soldesign/SwarmPLCmodem/console/ping test.JPG

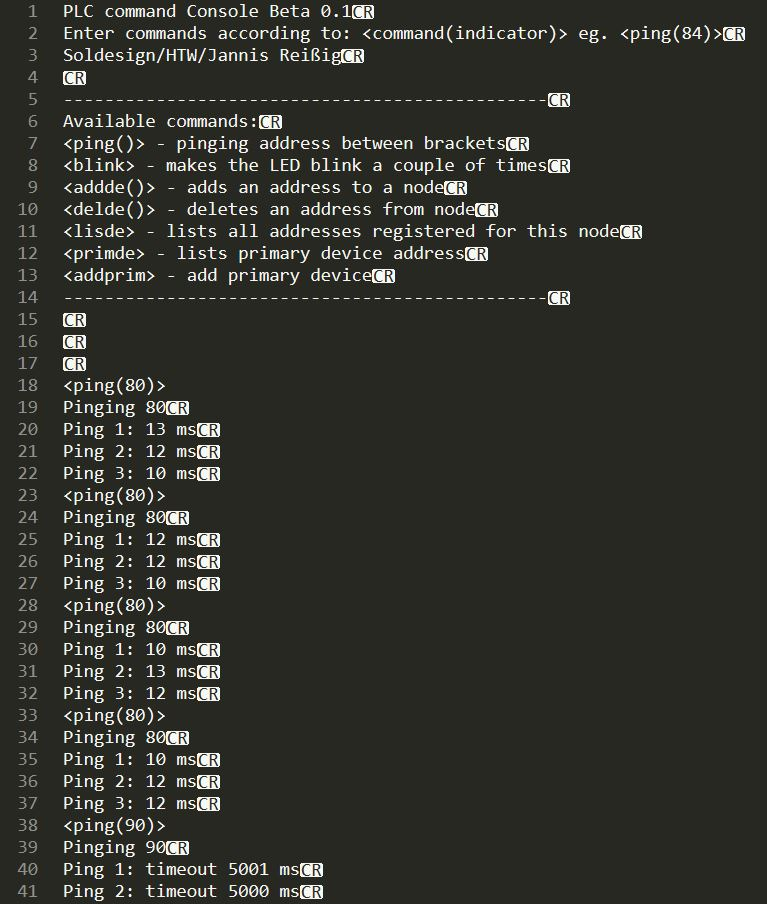
console/ping test.JPG
