soldesign/SwarmPLCmodem/3NodeTest/20180124_142106.jpg

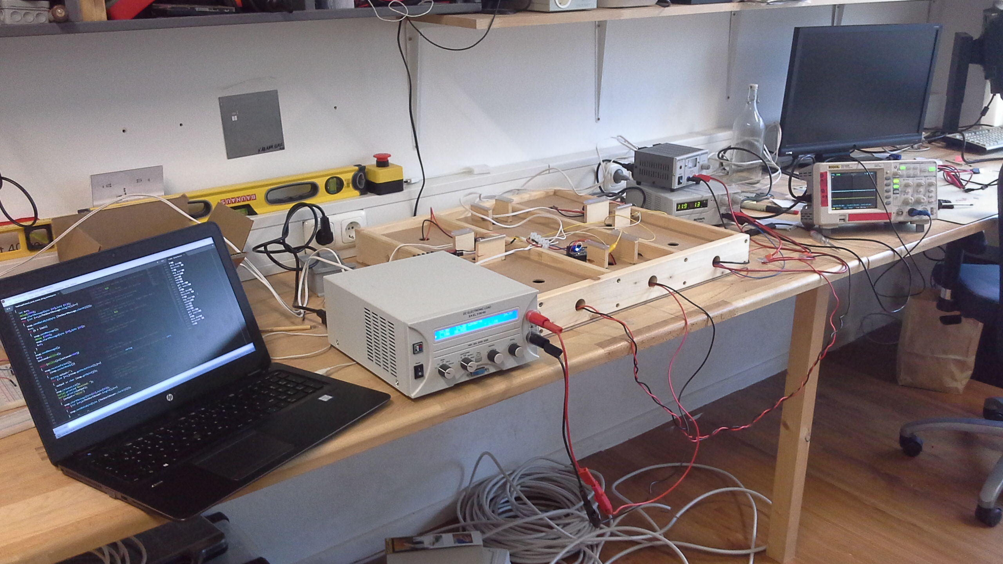
3NodeTest/20180124_142106.jpg
