soldesign/SwarmPLCmodem/US20030045970.pdf

# (19) United States

US 20030045970A1

## (12) Patent Application Publication (10) Pub. N0.: US 2003/0045970 A1

Maryanka | (43) Pub. Date: | Mar. 6, 2003
(54) SIGNALING OVER NOISY CHANNELS
(75) Inventor: Yair Maryanka, Tel Aviv (IL) Correspondence Address:
DR. MARK FRIEDMAN LTD
c/O ANTHONY CASTORINA
SUITE 207
2001 JEFFERSON DAVIS HIGHWAY ARLINGTON, VA 22202 (US)
(73) Assignee: YAMAR ELECTRONICS LTD
(21) Appl. No.: | 09/941,598
(22) Filed: | Aug. 30, 2001

Publication Classi?cation

(51) Int. Cl.7 | G05D 3/12; G05D 5/00;
G05D 9/00; G05D 11/00;
G05D 17/00
(52) US. Cl | 700/293

592

(57) ABSTRACT

The present invention relates to a system and method for signaling among a plurality of devices via a communication carrier over a noisy medium such as a poWer line and particularly relates to an innovative method and system for high speed signaling using an innovative modulating scheme. The scheme is particularly Well adapted for signal ing over multiple channels and over direct current (DC) poWer lines. At the transmitter end, a modem modulates data to be transmitted according to a modulation scheme and a signaling shifter modi?es the carrier according to a modi ?cation scheme. At the receiver end, a modem demodulates the data according to the modulation scheme and a detector detects the signal in accordance With the modi?cation scheme. Signals may be received over multiple channels. A signal is sent over a subset of the channels. Remaining channels can be used for competing signals avoiding inter ference. The channel chosen for sending a signal may also indicate signal priority. An innovative device is presenting for testing communication over DC poWer lines With adjust able attributes.

# 594b lose /

arbitration

536
send intend to | ‘534 x Postpone | Receive
use signaling | | transmission | Message

l
538 | listen for | 598
intend to use

## signaling

| 542
intend to | higher | lose | 4/. 5943
use? | priority | arbitration

### Start

Transmission 1

4

none or

## lower priority

win
arbitration

596

Patent Application Publication | Mar. 6, 2003 Sheet 1 0f 9 | US 2003/0045970 A1
0mm mwm | om.

# F mSmE

## N Erma .355

nww wwm | 3+ om. 3+ 8

## Bum ovm

# nmw

## iilili uozmn F _3E$

| om. 8+ 00. 8+8...

k
3%

## nvm oa

# own

# now

# mwu mmw mom

Patent Application Publication | Mar. 6, 2003 Sheet 4 0f 9 | US 2003/0045970 A1

# lll/ . nmhw

# v 23mm

0E. 35:» 03%. 9595mm 3b% 82a £2m E 5%.; 82a “25.9w at. 35% 29.5 @5335 vllllllllllllllllllll llllllllll n E65% 32a @5355

m

. W

# hm W g“image: 625E

n n" l uum E J WENgg £3: “ . .

kw mm .KQN “H KR E322 ._m.__.u._2=n_ Am mm QhwN at.“ Emuoi 3.35am vm H 2.3 E252 SREE mm 05w £5208: £555 m EM 5mm £5582 =2~§__.._ fnmhm nE-N .t" ...... u KHMHHNIiM. m om ERNEouQE EmRBBE

I. .555 @5655 223 n

# Ea $5.20 $80 mwm 68.21

L___..._.......__________ ___,____________......,.... ,__:=/

# ..\.., mmw

Patent Application Publication | Mar. 6, 2003 Sheet 6 0f 9 | US 2003/0045970 A1

# 11%? ²³⁹m @

00201 v

d a

n 361

a “02mm

# _‘ venom omw mugE

Patent Application Publication | Mar. 6, 2003 Sheet 7 0f 9 | US 2003/0045970 A1

# 3:23 .632 one: 3

### “"3: 5:25 cong?E

ill-ll»

## - :mE3 m. mmo

## 3% R . H Eg .5_

# wvm

# méwcmi ²⁹⁵ ⁸mm:* T/wnm gm in:..e

_\ ‘

## mémcm? comm??? m: mmmwmwz

# ml/ gm 295 ucmm 8@5931 mzmumm F

# mam

m .

53:26 52

32

959m N

Patent Application Publication | Mar. 6, 2003 Sheet 8 0f 9 | US 2003/0045970 A1

m m $8 $8 63222 “353

000

‘W.

m

# Jill 3% llmti mQw/vwl 3%

000 #8 3% :w ..

# wow w

83% 2 mé?gEEuu row

315v ugmuEzEEou .

w 9.5K

Patent Application Publication | Mar. 6, 2003 Sheet 9 0f 9 | US 2003/0045970 A1

# ommwwmE 0552mm c2382 ncmw mk $22, on 23% mL wagon ?omccou 23E

## 93mm m

## US 2003/0045970 A1

SIGNALING OVER NOISY CHANNELS

FIELD AND BACKGROUND OF THE INVENTION

[0001] The present invention relates to a system and method for signaling betWeen a plurality of devices over a noisy poWer line and particularly relates to innovative method and a system for high speed signals using a distinct modulating scheme over direct current (DC) poWer lines and multiple frequency channels, and an innovative device to test communication over DC poWer lines With adjustable conditions.
[0002] More and more tasks today require complete or partial computer control. Particularly in transportation, mul
tiple computers, sensors and actuators are an integral part of many machines. Cars, boats, aircraft, and trains use com puters to make the engine run ef?ciently, and to run climate control systems, radios, communication equipment, alarm systems, navigation equipment and on board radar. Tradi tionally, data Were passed betWeen computers, sensors and actuators through dedicated Wires and data buses. Large numbers of dedicated communication Wires greatly compli cates the production and maintenance of vehicles.
[0003] Recently there has developed interest in reducing the need for dedicated communication Wires by using exist ing electric poWer lines as a communication media. Interest has mostly been directed toWard using AC poWer lines to promote communication betWeen appliances, computers and equipment Within and between buildings.
[0004] Less attention has been directed toWard DC poWer lines, Which are used in vehicles. Using DC poWer lines for communication reduces the space and Weight dedicated to communication Wiring in vehicles including, for example, automobiles, trains, aircraft and satellites. Reducing the siZe and Weight of vehicles reduces cost of production and increases efficiency and performance.

### [0005] Maryanka (US. Pat. No. 5,727,025) teaches high

speed transmission of data over DC poWer lines With error control by means of channel coding and modulation. DC poWer-line communication may be over a single channel or multiple channels as presented in EAEC sixth European ITS conference in Cernobbio Italy on Jul. 2-4, 1997 by Mr. Aldo Romaro et al. “Super Integration In Automotive Electronics” page 1105.

[0006] When a plurality of devices communicates over a shared medium such as a DC poWer line, there is a need to coordinate sharing of the media. Therefore, in order to facilitate communication over noisy media such as DC poWer lines there must an ef?cient signaling method. Sig naling is used for sending predetermined messages; for example, to turn on or off a particular appliance. Signaling is also used for sending of supervisory information for maintaining communication on a channel. For example: a transmitter uses signaling to instruct a receiver to prepare for a neW transmission; a transmitter uses signaling to indicate intention to use a channel in order to prevent other trans mitters from interfering With communication on the channel; a receiver uses signaling to inform a transmitter of a recep tion error; a receiver uses signaling to inform a transmitter of a speed limitation, a receiver uses signaling to inform a transmitter of a congestion condition Wherein the receiver

## Mar. 6, 2003

cannot receive (for example: due to a full input buffer or due to an incoming message on a separate channel), a receiver uses signaling to send to a transmitter a request to retransmit.
[0007] Signaling is commonly used for collision detection and collision resolution (detection of potential interference betWeen transmissions by multiple devices on a channel and coordination of communication to avoid the interference). For ef?cient collision detection and resolution on a noisy channel, it is necessary to have a signaling method by Which competing transmitting devices can quickly signal their
intention to use the channel preventing other transmitters from accessing the channel.
[0008] DC poWer lines are considered typically as very noisy communication channels With high level impulse
noises, causing communication errors over a Wide range of frequencies. In addition, part of the frequencies available for communication may be blocked for long period of time as a result of Electro Magnetic Interference (EMI) or strong attenuation resulting from inter-symbol interference, fading
and standing Waves. The combination of Wide band short term impulse noise and long time period narroW band interference places stringent demands on signaling. Speci? cally, the high probability of blocked channels and the large
number of communication errors over DC poWer-lines results in an increased burden of coordination and an increased number of signals. On a noisy channel, signals must be resistant to frequency notch and blocking by noise.
[0009] Communication can be for the purpose of transfer ring arbitrary data or for the purpose of sending one of a predetermined set of messages. Errors cannot be readily detected or corrected in arbitrary data. Therefore, arbitrary data is generally transmitted via symbol codes that have high
resistance to random errors. Resistance to errors in symbol
codes is achieved by lengthening the symbol transmission period. Lengthening the symbol transmission period sloWs
communication.
[0010] Signaling is used for sending a message taken from a predetermined limited set of potential messages. A prede termined ?nite domain of signals corresponds to the prede termined ?nite set of messages. When a signal is corrupted, the corrupted signal Will seldom correspond to a signal in the domain of potential signals. Therefore, an error is easily recogniZed. When there is an error, the original intended signal can be retrieved by ?nding the legitimate signal most similar to the received signal. Thus, signals are inherently resistant to changing the meaning (aliasing). Therefore, the use in signaling of lengthened symbol codes developed for arbitrary data communication implies redundant error pro tection. Redundant error protection is inef?cient and unnec
essarily sloWs signaling.
[0011] VanderMey et al. (US. Pat. No. 6,034,988) teach a spread spectrum apparatus and method for netWork RF data

communications having extended communication channels. The spectrum spreading method of VanderMey ’988 is frequency hopping across a plurality of channels. Frequency hopping alloWs communication over noisy media. In order to permit simultaneous data hopping and carrier sensing multiple access—collision detection (CSMA-CD) Vander
Mey ’988 requires a means of fast signaling of a free channel. According to VanderMey ’988 fast signaling is to be achieved by a RF signal Within one sub-symbol of a data packet. HoWever, noWhere does VanderMey ’988 disclose a one sub-symbol signaling method. VanderMey does reveal a signaling method by a code of multiple symbols. Because each frequency hop must Wait until a signal can be detected on a neW channel, signal detection by a code of multiple symbols signi?cantly sloWs communication in the Vander Mey ’988 method.
[0012] Jaffe et al. (US. Pat. No. 5,485,147) teach a method and apparatus for scheduling access to a CSMA

communication medium. According to the method of J affe et al. ’147 signaling is over a dedicated channel that is not available for arbitrary data communication. The additional channel increases netWork cost because the additional chan nel requires eXtra hardWare for each component of the netWork and requires eXtra bandWidth.
[0013] Gold et al. (US. Pat. No. 5,488,631) teach a Wireless direct-sequence spread spectrum TDMA commu

nications system. The patent of Gold et al. ’631 discloses a
physical layer method for communication including signal
ing. The signaling method of Gold et al. ’631 is direct sequence spread spectrum communication (D555). D555 Was developed for arbitrary data communication. As such DSSS does not take advantage of the limited domain of signals. Thus signaling requests according to Gold et al. ’631 require more communication resources than optimiZed sig naling. Furthermore, DSSS requires the generation of com pleX pseudo-noise functions and modulation and demodu

lation of signals by means of the pseudo-noise functions. Generation and modulation With pseudo-noise functions increases the complication and eXpense of each transmitter and receiver on the netWork of Gold et al. ’631. The system of Gold et al. ’631 is Well suited for a D555 netWork Wherein transmitters and receivers are necessarily equipped With pseudo-random code generators and modulators and
Wherein messages are long. But in a netWork Where mes sages are short and devices are relatively simple, the method of Gold et al. ’631 requires dedication of an unnecessarily large quantity of resources to CSMA-CD and signaling.
[0014] Thompson (US. Pat. No. 5,726,976) teaches a
congestion sense controlled access for a star con?gured netWork. According to Thompson ’976 the communication
rate can be increased over a carrier sense netWork (With
emphasis on Ethernet netWorks) by reduction of the packet length. Thompson ’976 further reveals a method for dupleX communication over star con?gured netWork. In order to
achieve full duplex, Thompson ’976 requires in-band sig
naling. While one goal of Thompson ’976 is to reduce the communication packet length the revealed method of in band signaling requires block encoding including eXtra signaling bits in the transmitted data. Block encoding increases the packet length and decreases communication
ef?ciency.
[0015] Communication devices are often required to func tion under a variety of conditions. For eXample a particular set of devices may be used in different vehicles and under different operating conditions. When developing or trouble shooting a communication device it is unfeasible and pro hibitively expensive to install and test a device in every possible con?guration and under all possible conditions. Therefore testing is done using a testing apparatus.
[0016] Prior art systems for testing a communication device require installation into a particular environment or do not alloW for varying the testing conditions Without permanent modi?cation of the testing apparatus. For eXample, WiecZorek, et al. (US. Pat. No. 5,703,479) reveal a system for loopback testing of electronic equipment. But

the method of WiecZorek et al. ’479 makes no alloWance for changing conditions under Which the equipment operates. Fieramosca, et al. (US. Pat. No. 5,950,149) reveal a “Method for testing vehicle electrical system during manu

facturing”. The method of Fieramosca et al. ’149 requires testing the electrical system after installation in a car and cannot make account for individual differences betWeen cars or changes in conditions (for eXample, as a car ages). Yoshida, et al. (US. Pat. No. 6,205,202) reveal a method of testing home communications lines. Yoshida ’202 fails to consider the importance of differing performance under particular environmental conditions.
[0017] There is thus a Widely recogniZed need for, and it Would be highly advantageous to have a signaling system and method to alloW fast signaling and CSMA-CR over noisy communication circuits. Further, there is a Widely recogniZed need for, and it Would be highly desirable to have a device to facilitate testing of communication installed in different pieces of equipment or functioning under varying environmental conditions.
[0018] De?nitions
[0019] For the sake of the present patent the folloWing de?nitions Will be used:
[0020] a collision is an intent of a plurality of trans mitters to transmit during a particular common time period on a speci?c channel;
[0021] a collision resolution is a decision not to transmit during the particular time period on the speci?c channel in all but one transmitter involved in
a collision.
[0022] a channel is a de?ned part of communication carrier through Which a limited quantity of informa tion is transmitted; for eXample, a channel may include a frequency band from a frequency range in a radio signal or in an optical signal, and a Wire from a group of Wires;
[0023] a communication carrier is a vehicle by Which a message may be sent; electromagnetic Waves,
sound or ultra-sonic vibrations are common
eXamples of communication carriers;
[0024] a communication medium is a physical vessel for conveying a communication carrier; eXamples of
media include but are not limited to a Wire, an electromagnetic ?eld, a conduit, and an optical ?ber;
[0025] a device is a member of communication net Work that may include components to serve any function and is con?gured to send a signal, receive a signal or both transmit and receive a signal.

SUMMARY OF THE INVENTION

[0026] The present invention is a system and method for signaling among a plurality of devices over a noisy medium and particularly relates to innovative method and system for high-speed signals using a distinct modulating scheme over direct current (DC) poWer lines and multiple frequency channels. The invention further reveals an innovative device to test communication over DC poWer lines With adjustable conditions.
[0027] According to the teachings of the present invention there is provided a method of transmitting an arbitrary datum over a channel and for sending a signal over the channel. The method includes the steps of modulating the arbitrary datum onto a carrier by a modulation scheme for transmitting the arbitrary datum and modifying the carrier by a modi?cation scheme for sending the signal.
[0028] According to further features in preferred embodi
ments of the invention described beloW the modulation scheme includes transmitting a plurality of consecutive symbols at a symbol rate and the modi?cation scheme includes modifying said carrier at a modi?cation rate, the modi?cation rate being higher or loWer than the symbol rate.
[0029] According to further features in preferred embodi
ments of the invention described beloW the modulation or the modi?cation may be effected by binary phase shift keying (BPSK), quadrature phase shift keying (QPSK), amplitude modulation (AM), frequency modulation (FM), or code division multiple access (CDMA).
[0030] According to still further features in preferred embodiments of the invention described beloW the signal is used to communicate a message that includes but is not limited to an intention to transmit, an end of transmission, a congestion condition (for eXample a full receive buffer or a receiver speed limitation), an instruction to turn on a device, and instruction to turn off a device, a request to retransmit,
a dominant status and a recessive status.
[0031] According to still further features in preferred embodiments of the invention described beloW the carrier is conveyed over a medium. The medium may include but is not limited to a utility poWer line, a DC poWer line, a dedicated communication Wire, a ?ber optic cable, and a magnetic ?eld.
[0032] According to still further features in preferred embodiments of the invention described beloW the modu lating and the modifying are effected substantially simulta
neously.
[0033] According to still further features in preferred embodiments of the invention described beloW the pattern of modi?cations is used to estimate the channel probability of errors and to adjust the usage of a channel according to that estimated probability of communication errors.
[0034] According to another embodiment of the present invention there is provided, a receiver for receiving an arbitrary datum from a channel of a communication carrier and for receiving a signal over the channel. The receiver includes a modem for demodulating the arbitrary datum and a detector to detect the signal. The datum is modulated by a modulation scheme and the signal is sent via modi?cations of the carrier according to a modi?cation scheme.
[0035] According to further features in preferred embodi
ments of the invention described beloW the modi?cation scheme includes a pattern of modi?cations to the carrier. In order to identify the pattern, the receiver includes a proces

sor.
[0036] According to still further features in preferred embodiments of the invention described beloW the modu lation scheme includes modulating a symbol onto the carrier over a symbol period and the pattern includes a plurality of modi?cations Within the symbol period.
[0037] According to still further features in preferred embodiments of the invention described beloW the processor includes consisting of but is not limited to a programmable logic array device, an application speci?c integrated circuit, or a digital signal processor.
[0038] According to still further features in preferred embodiments of the invention described beloW the modu lation scheme includes modulating a plurality of symbols onto the carrier at a symbol rate and the pattern includes a plurality of modi?cations. The modi?cations are superim posed onto the carrier at a modi?cation rate. The modi?ca tion rate may be higher or loWer than said symbol rate.
[0039] According to still further features in preferred
embodiments of the invention described beloW a pattern identi?cation criterion is adjusted according to communica tion performance.
[0040] According to still further features in preferred embodiments of the invention described beloW the processor further adjusts a usage of a channel for an arbitrary datum transmission according to communication performance.
[0041] According to yet another embodiment of the present invention there is provided a transmitter. The trans mitter is for transmitting an arbitrary datum over a channel of a communication carrier and for sending a signal over the channel. The transmitter includes a modem for modulating the arbitrary datum according to a modulation scheme, and a signaling shifter to modify the communication carrier according to a modi?cation scheme.
[0042] According to still further features in preferred embodiments of the invention described beloW the modi? cation scheme includes a pattern of modi?cations. In order to produce the pattern, the transmitter further includes a signaling pattern generator for controlling the shifter.
[0043] According to still further features in preferred embodiments of the invention described beloW the modu lation scheme includes modulating a symbol onto the carrier over a symbol period and the signaling pattern includes a plurality of modi?cations. The pattern is transmitted Within the symbol period.
[0044] According to still further features in preferred embodiments of the invention described beloW the modu lation scheme includes modulating a plurality of symbols onto the carrier at a symbol rate and the modi?cation scheme includes a plurality of modi?cations at a modi?cation rate. The modi?cation rate may be higher or loWer than the symbol rate.
[0045] According to still further features in preferred embodiments of the invention described beloW the signaling pattern generator includes a processor. The processor may include but is not limited to a programmable logic array device, an application speci?c integrated circuit, and a digital signal processor.
[0046] According to still further features in preferred embodiments of the invention described beloW the signaling pattern is altered to adjust the usage of a channel according to communication performance.

[0047] According to yet another embodiment of the present invention there is provided a method of signaling during communication by a plurality of devices over a plurality of channels. The method includes the steps of a ?rst devices sending a ?rst signal on a ?rst channel and a second device listening for the signal over a subset of the channels. The subset of channels includes the ?rst channel and a second channel.
[0048] According to still further features in preferred embodiments of the invention described beloW the signaling method further includes the step of the ?rst device detecting a second signal over the second channel.
[0049] According to still further features in preferred embodiments of the invention described beloW the second device includes a transmitter. The second device listens for a signal for the sake of collision detection or collision resolution. The transmitter of the second device transmits according to arbitration of the signal resolution.
[0050] According to still further features in preferred embodiments of the invention described beloW the ?rst signal is communicating an intention to transmit over some or all of the channels.
[0051] According to still further features in preferred embodiments of the invention described beloW the method of signaling for collisions resolution further includes the step of assigning a signal priority level to the ?rst signal. Reso lution of con?icts is according to the signal priority level.
[0052] According to still further features in preferred
embodiments of the invention described beloW a channel of the subset of channels used for signaling is associated With a channel priority level. The signal priority level is assigned according to the channel priority of the channel over Which the signal is sent.
[0053] According to yet another embodiment of the present invention there is provided a method for signaling during communication by a plurality of transmitters over a plurality of channels. The method includes the steps of sending a ?rst signal from one of the transmitters on at least one channel and listening by the transmitter for a second signal from a second transmitter over a second channel.
[0054] According to yet another embodiment of the present invention there is provided a system for testing
communication amongst a plurality of devices over a medium. The system comprises an adjuster to change an attribute of the medium and a DC poWer supply for supply ing a DC voltage to the devices. The DC poWer supply is decoupled from transmissions from the devices by an induc
tor.
[0055] According to still further features in preferred embodiments of the invention described beloW the attribute of the medium changed by the adjuster includes but is not limited to attenuation, impedance, frequency response, noise pattern, or noise level.
[0056] According to yet another embodiment of the present invention there is provided a method for testing communication betWeen tWo devices via a medium. The method comprises the steps of connecting the devices to the medium, adjusting an attribute of the medium, conveying a
message over the medium from a ?rst device to a second device, determining Whether the message is received by the second device; and imposing a DC voltage on at least one of the devices.
[0057] The present invention successfully addresses the shortcomings of the presently knoWn con?gurations by providing a method and system for fast signaling. Signals may be sent at a rate higher than a symbol rate. Fast signaling makes communication betWeen multiple devices more efficient. Fast, reliable signaling is particularly increases ef?ciency of communication over a noisy medium such as a DC poWer line. The current invention also dis closes a novel system and method for testing communication over a DC poWer line. The system and method for testing communication saves money developing and testing com munication devices by enabling testing of communication under varied Working conditions Without requiring installa tion of communication devices in different vehicles.

BRIEF DESCRIPTION OF THE DRAWINGS
[0058] The invention is herein described, by Way of eXample only, With reference to the accompanying draWings, Wherein:
[0059] FIG. 1 is a schematic illustration of a modi?ed Wave used for signaling according to the present invention;
[0060] FIG. 2a is a schematic draWing of an embodiment of signaling phase detector according to the present inven tion;
[0061] FIG. 2b is a schematic draWing of an embodiment of a signaling phase shifter according to the present inven tion;
[0062] FIG. 3 is a schematic draWing of an embodiment of a multi-channel receiver With signaling according to the present invention;
[0063] FIG. 4 is a schematic draWing of an embodiment of a multi-channel transmitter With signaling according to the present invention;
[0064] FIG. 5 is a schematic draWing of an alternative embodiment of a multi-channel transmitter according to the current invention;
[0065] FIG. 6 is a schematic illustration of a collision resolution on a single channel according to the current
invention;
[0066] FIG. 7 is a How chart of a method for collision resolution according to the present invention;
[0067] FIG. 8 is a schematic draWing of a system to test signaling and communication amongst devices according to the present invention.
[0068] FIG. 9 is a How chart of a method for testing a communication amongst devices according to the present invention.

DESCRIPTION OF THE PREFERRED EMBODIMENTS

[0069] The present invention relates to a method for signaling among a plurality of devices over a noisy media and particularly relates to an innovative method and a system for signaling over DC poWer lines and an innovative device to test signaling and communication over DC power lines amongst a plurality of devices under varied conditions.
[0070] The principles and operation of method and a system for signaling over noisy media such as DC poWer lines according to the present invention may be better understood With reference to the draWings and the accom
panying description.
[0071] FIG. 1 illustrates a signaling Waveform according
to the current invention. For illustrative purposes the Wave form is shoWn repeated tWice. The medium in FIG. 1 is a DC poWer line. The carrier in FIG. 1 is a RF Wave. The signaling channel is a frequency band. The frequency band is primarily used for arbitrary data communication. The arbitrary data communication modulation scheme in FIG. 1 is BPSK at a symbol rate of 636 kHZ. In BPSK modulation, symbols are communicated by 90 degree phase shifts 20a and 20b at the beginning 22a, 22b of each symbol period. For example, the symbols are bits and the symbol period is 1/636,000 sec. In FIG. 1, are shoWn tWo consecutive symbols. In the embodiment of FIG. 1, the symbol period for arbitrary data communication, is six cycles of the carrier Wave. Phase shifts for arbitrary communication are alWays at the begin ning of a symbol period and never Within the symbol period. In order that the symbol period include six cycles of the carrier Wave at a symbol rate of 636 kHZ, the carrier frequency is 3.8 MHZ. Other common modulation schemes include but are not limited to QPSK, FM, AM, CDMA and combination of the above modulation schemes such as
frequency key shifting for arbitrary datum and amplitude modulation for signaling.
[0072] Random noise on the channel causes random phase shifts of the carrier Wave. A data error occurs When noise causes a consistent shift over most of the symbol period. Random noise is unlikely to consistently affect the phase of the Wave over many cycles. Therefore, as the symbol period increases, the likelihood of errors from random noise decreases.
[0073] In the embodiment of FIG. 1, fast signaling is achieved by modifying the carrier With a scheme of multiple phase shifts Within a single pattern period. There is at least one full cycle of the carrier Wave betWeen any tWo phase shifts to alloW differentiation betWeen Sine and Cosine Waves. In a real netWork, signals and arbitrary communica tion symbols are not generally transmitted simultaneously. Nevertheless, for the sake of illustration, FIG. 1 includes phase shifts 24a-24e for signaling. Phase shifts for signaling may also occur at the beginning of a symbol period, for example phase shifts 20a-20b. Speci?cally one symbol period in FIG. 1 contains six phase shifts for signaling 24a, 24b, 24c, 24d, 24c and 20b. Thus the modi?cation rate is 6><636=3.8 MHZ. Phase shifts 24a-24e and 20b, Within one symbol period are +90, +90, —90, +90, —90 and —90 degrees. Thus, in arbitrary data communication When using BPSK
modulation, only one binary bit can be transmitted in a single a symbol period. Whereas in signaling, one of up to 26 predetermined signals can be transmitted in a pattern period. In FIG. 1, the signaling pattern period and the arbitrary data symbol period are the same length. In an alternative embodiment, the signaling period could be longer or shorter than the arbitrary data symbol period. In FIG. 1, the pattern rate is equal to the carrier frequency. The pattern rate may be less than the carrier frequency. In actuality, the number of predetermined potential signals is
much less than 26 therefore only a feW patterns are legitimate signals. The small ratio of legitimate signaling patterns to possible patterns alloWs distinction betWeen noise and intended signaling patterns. Multiple-phase shifts in a short period increase the likelihood that a receiver Will not detect all of the phase shifts. Therefore in the embodiment of FIG. 1, When a receiver receives a pattern, Which may not be an exact replica of the transmitted signal, the receiver must decide if the pattern resembles a knoWn signal. For example, the criterion for identi?cation of the signal of FIG. 1 is detecting ?ve of the six phase shifts of the pattern of FIG. 1.
[0074] Other possible modi?cation schemes include but are not limited to amplitude shifting or frequency shifting. For example, multiple amplitude shifts may be made in a symbol period and amplitude shifts may be by a factor of 0, —1, or 1/2.
[0075] A modi?cation of a carrier for the sake of signaling according to the present invention is not limited to changing the phase of an electrical Wave. The carrier of a signal may be light for example in a ?ber optic cable. Similarly the communication medium may be an air conduit and the communication carrier may be sound Waves. Methods used to modulate the carrier may include frequency modulation and amplitude modulation. Further examples of modi?ca tions include frequency shifting for example a PM chirp or modi?cation of chirps.
[0076] FIG. 2a is an example of a signaling phase detector 70 for detecting phase modi?cations in a carrier of a signal
100. Signal 100 consists of phase shifts similar to the signaling Waveform in FIG. 1. A digital logic circuit con tains tWo detector arrays 105i and 105q. Detector arrays 105i and 105q contain generators of a reference signal I 125i and a reference signal Q 125q respectively. Reference signal Q is shifted by 90 degrees from reference signal I. Both reference signals Q and I have the same frequency corre sponding to a transmitter carrier Wave. Both reference signals Q and I are synchroniZed to received signal 100 by means of a Phase Lock Loop 115. Received carrier signal 100 passes through a band pass ?lter 275a'a'. The central frequency of ?lter 275a'd is the base frequency of the transmitter carrier Wave of signal 100. Signal 100 is con verted by a comparator 130 into digital form and compared With reference signals I and Q. Detector arrays, 105i and 105q further each contain a fast counter FCI 135i and FCQ 135q respectively. A phase difference betWeen received signal 100 and reference signals I and Q is measured by means of fast counters FCI 135i and FCQ 135q. Aprocessor 140 compares expected phase values to measured phase values of the carrier Wave of signal 100. If the difference is less than a preset threshold, the decision logic outputs a “signaling detected” response 145 as required according to signal 100. Based on differences betWeen expected phase shifts and detected phase shifts, processor 140 evaluates communication performance. For example, processor 140 provides an estimated channel bit error rate to output 146. Processor 140, detector arrays 1051 and 105q, and PLL 115 may include but are not limited to a programmable logic array device, an application speci?c integrated circuit and/or a digital signal processor. Different types of decision logic

processors 140 can be implemented for more sophisticated soft decisions. The band pass ?lter 275a'a' can be imple mented as discrete LC ?lter or as a digital ?lter.
[0077] Processor 140 evaluates communication perfor mance based on the difference betWeen a received signaling

pattern and an expected pattern. Estimation of communica tion performance may be made periodically using a knoWn calibration pattern, or estimation of communication perfor mance may be made “on line” based on received signals.
[0078] For example, for the pattern of FIG. 1, processor 140 tracks the number of signals Wherein all six phase shifts are detected and the number of signals Wherein only ?ve of the six phase shifts are detected. When the ratio of signals With six detected shifts to signals With ?ve detected shifts is less than 100:1, then it is assumed that some signals With four detectable shifts are being lost. Therefore, processor 140 adjusts the usage of the channel. Alternatively, along With identifying signi?cant signals Wherein ?ve or six of phase shifts from amongst 20a and 20b and 24a-24e are detected, processor 140 also tracks possibly missed mes sages Wherein four phase shifts from amongst 20a and 20b and 24a-24e are detected. When the ratio of signi?cant signals to possibly missed messages is less than 1000: 1, then it is assumed that some signals With four detectable shifts are being lost. Therefore, processor 140 adjusts the usage of a channel both for arbitrary datum and signaling.
[0079] Strategies to adjust the usage of a channel include but are not limited to change a pattern length, change a pattern identi?cation criterion and cease use of a channel for communication. By altering a signaling pattern length or a criterion for pattern identi?cation, the probability of signal ing errors (false negative or false positive) can be adjusted according to channel noise.
[0080] Methods by Which processor 140 adjusts a usage of a channel for an arbitrary datum transmission according to communication performance include but not limited to changing a symbol rate and changing an error protection ECC algorithm. In order to change an ECC algorithm, processor 140 sends a signal to a transmitter, instructing the transmitter to change ECC. The transmitter automatically informs intended receivers of the chosen ECC. For example, When the communication error rate is high, processor 140 sends a signal to a transmitter to change to a longer ECC that can correct a higher proportion of errors.
[0081] For example in the embodiment of FIG. 1, When a large number signals are being lost (false negative), proces sor 140 decides to change the pattern identi?cation criterion

by reducing the required number of detected phase shifts for identifying a signal. Speci?cally, the number of phase shifts required to identify the signal is reduced from ?ve of the six to four of the six.
[0082] There is a possibility that noise Will produce a short-term phase shift similar to signaling phase shift 24a or
24b or 24c or 24d or 246 or 20b. Nevertheless, the prob ability is loW that noise Will produce ?ve tuned phase shifts that Would be identi?ed as the pattern of FIG. 1 (false positive identi?cation error). Reducing the number of phase shift detections required for identifying a signal increases the probability of a false positive identi?cation.
[0083] Changing the length of a pattern can help decrease both false negative errors (lost signals) and false positive errors. Increasing the number of phase shifts required to identify a pattern reduces the probability of a false positive identi?cation. Decreasing the portion of signal phase shifts required to be detected for signal identi?cation reduces the probability of false negative errors. Thus, When there are serious consequences to false positive identi?cation error and When the channel is noisy, processor 140 increases the number of phase shifts in the signal from six to eight and increases the number of detected phases shifts required for identi?cation of the signal from ?ve to six. In order that the neW signaling pattern of eight phase shifts have one cycle of the carrier Wave for each phase shift, the signal period in FIG. 1 is increased to eight cycles of the carrier frequency. Thus, increasing the pattern length decreases the probability
of signaling error but sloWs signaling. In order to implement a change in signal pattern length, processor 140 must inform other devices on the netWork of the change in signaling pattern. A decision to change a criterion for identifying a pattern may be made by processor 140 as described above. Alternatively, a decision to change a criterion for identi? cation of a pattern may be made externally. For example., based on the detected error rate, a human operator may decide implement a neW signal identi?cation criterion. The decision of the operator may be based on the evaluation of communication performance provided in output 146 or the decision of the operator may be based on other data available to the operator. Alternatively, another device on the netWork may decide to change the identi?cation criterion and the other device then signals detector 70 instructing processor 140 to implement the change.
[0084] When the consequence of signaling error is par ticularly dire and noise on a channel is particularly high, processor 140 decides to stop using the channel for arbitrary datum and signaling. Other transmitters and receivers of the netWork are instructed to cease use of the channel and direct the arbitrary datum to other channel.
[0085] Although the present invention is intended prima rily for use With Direct Current (DC) poWer lines, this signaling method is suitable for a variety of noisy commu nication media. Examples of other communication media for Which this signaling method is suitable include but are not limited to alternating current (AC) utility poWer lines, radio transmissions including microWave and satellite transmis sions, and communication over dedicated Wires such as internal Wiring in a car or communication cables including
phone lines.
[0086] FIG. 2b illustrates a signaling phase shifter 71. A multi phase carrier generator 180 generates a base carrier Wave. Phase shifts are added to the base carrier Wave by a transmit phase selector 170. The phase and frequency of the base carrier Wave and the pattern of phase shifts are both controlled by a signaling pattern generator 190. Signaling pattern generator 190 controls carrier generator 180 and phase selector 170. The output signal of phase selector 170
is tuned by a band pass ?lter 275cc and conducted to the communication medium, in this case a DC poWer line 150. For example, signaling shifter 71 may be a ?eld program mable gate array (FPGA).
[0087] FIG. 3 is a schematic vieW of a multi-channel data and signaling receiver 230. Receiver 230 receives modu lated information 272a conveyed over a DC poWer line. Modulated information 272a is divided into eight channels F0-F7 (each channel being a frequency band) by an array

274a of eight band pass ?lters 275a-275h. For example, output of ?lter 275a is channel F0. The Waveform of channel F0 is output to a signaling phase detector 70a and to a communication modem 277a. Adetailed schematic drawing of signaling phase detector 70 is shoWn in FIG. 2a. Wave forms of channels F0-F7 are selected by ?lters 275a-275h respectively. Outputs of ?lters 275a-275h are passed to modems 277a-277h of modem array 276a respectively and to signaling phase detectors 70a-70h respectively of signal ing phase detectors module 278 and channel access signal ing controller module 281.
[0088] Phase detector 70a demodulates signals contained in channel F0. Phase detector 70a detects a modi?cation in channel F0, the modi?cation being a phase shift. Similarly signals in channels F1-F7 are demodulated by phase detec tors 70b-70h respectively. Output from signaling phase
detectors 70a-70h is output to channel access and signaling detection controller 281. Controller 281 controls a decoder and multiplexed de-interleaver 284. Controller 281 may also send a message 285 to a transmitter 350 (FIG. 3) instructing transmitter 350 to transmit or Wait depending on the status of a communication channel. There are different types of signals. Signal types include but are not limited to a start receiving signal, an arbitration signal for example an inten tion to transmit signal or an end of transmission signal, a retransmit signal (sent by a receiver for example When an error is detected in a data transmission), a congestion condition signal (for example sent by a receive When a receiving buffer is full or sent by a receiver to Which are directed multiple transmissions). When the channel bit rate is high, i.e. above 1 Mbps, equalization circuitry may be required to overcome the DC poWer line inter-symbol inter ference effects.
[0089] Arbitrary data contained in modulated information 272a is demodulated into eight separate demodulated bit streams 287a-287h by modem array 276a. Bit streams 287a-287h are combined (de-interleaved) rearranged (de multiplexed) and corrected from line errors (decoded With an error correction code) into the message data stream 282a by a decoder and multiplexed de-interleaver 284.
[0090] Filter array 274a is implemented as a discrete LC netWork, Where each ?lter is centered to a particular fre quency band. Each particular frequency band is the physical channel. Alternatively, ?lters array 274a is implemented by
digital signal processing.
[0091] FIG. 4 illustrates a ?rst embodiment of a multi channel signal and data transmitter 350 according to the
current invention. Adata stream 282b enters a channel coder and multiplexing interleaver 385 Where data stream 282b is protected by an error correction code and converted into a bit stream of sub-Words. The bit stream is directed as eight bit sub-streams 287m-287i to eight different channels F0-F7. The bit sub-streams 287m-287i are directed to a modem array 276b including eight modems 277m-277t. An indi vidual bit sub-stream 287 is modulated by a corresponding modem 277 via a corresponding band pass ?lter 275 onto a corresponding channel. For example, bit sub-stream 287m is modulated by modem 277m via band pass ?lter 275m onto channel F0. Each modem 277m-277i operates at a different carrier frequency With a corresponding band pass ?lter 275m-275i of ?lter array 274b. The combined outputs of all the ?lters are transmitted (conducted) as modulated infor mation 272b into a DC poWer line. The poWer line conveys (conducts) the carrier to a receiver such as receiver 230 of FIG. 3.
[0092] When required (eg automatically by receiver error
decoder 284 or for channel arbitration process of collision detection and resolution before starting transmission), trans mitter 350 sends signals using a signaling and channel access module 386a of eight signal shifters 71a-71h. Each signaling shifter modulates a signal onto a corresponding channel. For example, signaling shifter 71a modulates a signal onto channel F0. The details of signaling shifter 71a
are shoWn in FIG. 2b.
[0093] FIG. 5 illustrates an alternative embodiment 460 of a transmitter according to the current invention. A data stream 282c enters an interleaver 389 Where the stream is divided into eight data sub-streams 282d-282n each data sub-stream being directed to a corresponding channel. For each channel there is a corresponding data error correction coder (ECC) 480a-480h. For example data sub-stream 282d is converted into sub-Words and protected With an error correction code by ECC 480a. Each ECC 480 outputs a respective bit sub-stream 287. For example, ECC 480a outputs bit stream 287u. Each bit sub-stream is modulated by a corresponding modem 277u-277bb. Each modem 277u 277bb operates at a different carrier frequency With a cor responding band pass ?lter 275u-275bb. The combined outputs of all the ?lters are transmitted (conducted) as modulated information 272c into a DC poWer line to be conveyed to a receiver 230.
[0094] When required, transmitter 460 sends signals on a subset F4-F7 of channels F0-F7 by means of four phase shifters 71m-71p in a signaling and channel access module 386b. It is apparent that a transmitter or receiver may transmit signals on any number of channels. For example a netWork may use eight channels for transmitting data and use only a subset of one or tWo of the eight channels for signals. Alternatively, in a netWork, eight channels may be used for transmitting data, and all eight channels may be used for signaling. Aparticular transmitter may send a signal
on one channel, all of the available channels or any subset of the available channels.
[0095] FIG. 6 illustrates the use of the signaling pattern of FIG. 1 in arbitration for channel access by means of collision detection and resolution over a single channel. In FIG. 6 tWo devices labeled device 490 and device 495 are communicating over a shared channel. Each device 490 and 495 includes a transmitter (for example transmitter 460 except that in FIG. 6, signaling is only on one channel) and associated receiver (for example receiver 230). A mecha nism for collision resolution (arbitration) is required. Each
Device 490 and 495 starts a data transmission With a random or unique combination of signaling send and receive peri ods. If, during a receive period of device 495, device 495 detects an intent to transmit signal from device 490 then device 495 loses the arbitration and device 495 postpones transmission While receiving a message from device 490. During the arbitration transmit periods, the transmission signals contain a predetermined combination of phases as illustrated in FIG. 1 for best signaling detection on a noisy channel.
[0096] The arbitration receive/send combination is deter mined either on priority basis, or randomly. In the example of FIG. 6, devices 490 and 495 decide to transmit at the same time. Each device 490 and 495 signals independently an intention to transmit. According to the predetermined signaling schedule stored in device 490, before device 490 transmits, device 490 signals an intention to transmit in ?rst time period and listens in a second time period. If no competing intention to transmit signal is received in the second time period, device 490 again signals an intention to transmit in a fourth and a ?fth time period and listens for a competing signal in a siXth time period. If no competing signal is received in the siXth period, device 490 sends a signal in a seventh time period. Device 495 also has signals according to a predetermined schedule before transmitting. The signaling schedule of device 495 speci?es that before transmitting, device 495 signals in a ?rst and third period and listens in a second and fourth period. If no competing signal is received during the second and fourth periods, device 495 sends a signal in a ?fth period. Thus in the eXample of FIG. 6, Wherein devices 490 and 495 begin signaling simultaneously, during the ?rst three arbitration periods, both 110 devices 490 and 495 send and receive their signals at the same time. In the fourth period, device 495 receives and detects the signal from device 490. Therefore device 495 begins receiving a message from device 490, freeing the channel for device 490 to transmit. Thus, device 495 loses the arbitration and device 490 Wins the arbitration.
[0097] The channel over Which a signal is transmitted may have no intrinsic signi?cance. Nevertheless, it is advanta geous to signal on multiple channels because in multi channel signaling, transmitters are not all signaling on the same channel. Therefore, a probability of collisions and interference betWeen signals is smaller. Speci?cally, in a multi-channel signaling, transmitter 350 signals intent to
transmit on channel F0 and listens by means of a ?rst associated receiver (similar to receiver 230) for a competing signal of intent to transmit on channels F1-F7. Simulta neously, transmitter 460 signals a competing intent to trans mit on channel F7 and listens via a second associated receiver (similar to receiver 230) for a competing signal of intent to transmit on channels F0-F6. Each transmitter Will receive the intent to transmit signal of the competing trans mitter. A collision Will be detected and can be resolved. If only one channel (for eXample F7) Were available for signaling for both transmitters 460 and 350, then the signal of transmitter 460 Would interfere With the signal of trans mitter 350. Similarly, the signal of transmitter 350 Would interfere With the signal of transmitter 460. When signals interfere, the collision is not detected or resolved.
[0098] Alternatively, a channel or group of channels is associated With a channel priority level and signal priority level is assigned according to the channel priority level of the group of channels over Which the signal is sent. For eXample, the priority level associated With each channel is the channel number (0-7 for channels F0-F7 respectively), and higher priority has precedence. Transmitter 350 sends an intent to transmit signal on channels F4 and F5. The signals on channels F4 and F5 are assigned signal priority levels four and ?ve according to the channel priority levels of channels F4 and F5. Transmitter 350 listens for a signal on channels F6-F7. Simultaneously, transmitter 460 transmits an intent to transmit signal on channels F5-F6 and listens for a signal on channel F7. The signals on channels F5 and F6 are assigned signal priority levels ?ve and siX according to the channel priority levels of channels F5 and F6. Trans mitter 350 receives the intent to transmit signal of transmit ter 460 on channel F6. The signal on channel F6 is assigned signal priority level siX (according to the channel priority of channel F6). Signal priority level siX is higher than the highest signal priority assigned to a signal of transmitter 350, ?ve. Therefore transmitter 350 loses the arbitration and may not transmit. On the other hand, transmitter 460 does not detect a signal on channel F7. Therefore, transmitter 460 Wins the arbitration and goes ahead transmitting a message. Thus the collision is resolved according to priority levels of the signals. Transmitter 460 having the highest signal pri
ority level is given exclusive right to transmit a message.
[0099] FIG. 7 is a ?oWchart of a method for collision resolution. A ?rst transmitter 350 has to arbitrate use of a communication line With other devices (for eXample a second transmitter 460). The communication line is a ?Xed set of channels. Speci?cally, before transmitting a message, transmitter 350 Warns other devices not transmit over any channel of the line. Transmission of a second transmitter 460 on a channel of the line during a transmission of transmitter 350 Would interfere With the transmission of transmitter 350. The Warning is a signal of intention to start transmission over the line. Signaling should not consume long periods of time.
[0100] A device 490 (FIG. 6) including transmitter 350
and receiver 230 requires access to a communication line. Device 490 begins 592 by ?rst determining 532 if the line is currently idle. If the line is in use by an active transmitter, then transmitter 350 postpones 534 transmission While receiver 230 receives a message 598 from the active trans mitter. When the active transmitter has ?nished transmitting, transmitter 350 restarts 592 the process of attempting to transmit.
[0101] When the channel is idle, transmitter 350 sends 536 an intent to transmit signal and listens 538 for a competing intent to transmit signal from another transmitter. It is understood that signaling may be over any subset of the channels pertaining to the line. The subset may be single
channel or a plurality of channels. The subset may be a proper or improper subset of the set of channels making up the line. A channel may be designated for either signaling
alone or data communication alone, or a channel may be used for both signaling and data communication. Where a plurality of channels is used for communication, a single
transmitter may use some or all of the channels. Generally, a given device Will signal on a proper subset of the set of channels making up the line, but the device Will listen for signals on all of the channels.
[0102] If 542 receiver 230 does not detect a competing intent to transmit signal or receiver 230 detects a competing intent to transmit signal of a priority level loWer then the priority level of the signal of transmitter 350 then receiver 230 informs transmitter 350 that transmitter 350 Wins the arbitration 596. Then transmitter 350 begins to transmit arbitrary data 599. Priority of a signal may be indicated by the channel upon Which the signal is transmitted. Priority may also be indicated intrinsically by the pattern of the signal. For eXample, suppose that there are four channels numbered one to four. All four channels are used both for signaling and data transmission. Signals on a higher num bered channel have priority over signals on a loWer num bered channel. In the embodiment of FIG. 7 there are tWo intent to transmit signal patterns, a ?rst pattern illustrated in FIG. 1 consists of ?ve phase shifts in a single symbol period. The phase shifts Within one symbol are —90, +90, +90, —90, +90, —90 and —90 degrees. The second symbol pattern (not shoWn) has three phase shifts of +90, —90, —90 equally spaced Within one symbol period. Signals on a given channel having the ?rst pattern are assigned a higher priority than signals of the second pattern on the given channel. A
transmitter uses as an end transmission signal, the same
signal pattern that the transmitter used at the beginning of a transmission as an intent to transmit signal. It is understood that differing signal patterns or channels may also be used differentiate betWeen types of signals or the identity of a signaling transmitter or the identity of an intended receiver.
[0103] When 542 receiver 230 detects a competing intent to transmit signal from a competing transmitter, channel access and signaling controller 281 determines the priority of the competing signal. Priority level is according to the channel upon Which the signal is transmitted and the form of the signal as stated above. If the competing signal of the competing transmitter is of higher priority than the signal of
transmitter 350, then receiver 230 sends a message 285 to transmitter 350 that transmitter 350 loses the arbitration 594a. The competing transmitter Wins arbitration 594a and therefore the competing transmitter transmits a message and transmitter 350 postpones transmission 534 While receiver 230 receives 598 the message from the competing transmit ter. After the competing transmitter completes transmission, transmitter 350 returns to the beginning of the transmission process 592C.
[0104] FIG. 8 illustrates a system 600 for testing the signaling and data communication amongst devices on a DC poWer line. In system 600, tWo devices 601a and 601b are communicating. Calibrated attenuations betWeen the tWo devices determine the communication channel quality over the DC poWer line.
[0105] A DC poWer supply 611 supplies a DC voltage to devices 601a and 601b. Inductors 604a and 604b decouple poWer supply 611 from voltage ?uctuations due to a com munication carrier (the carrier is a high frequency oscillating voltage). PoWer supply 611 is further decoupled from the communication carrier by capacitor 605a. Capacitor 605a nulli?es the residual communication carrier voltage by shorting the carrier to ground 606.
[0106] The communication carrier is conveyed betWeen device 601a and device 601b along a transmission medium
610. In system 600, medium 610 includes a Wire 607 and tWo adjusters 608a and 608b. Adjusters 608a and 608b are attenuators that adjust attenuation of medium 610. Along With attenuation, alternative attributes of medium 610 that may be adjusted include but are not limited to frequency response (by a ?lter array), noise pattern or noise level (by a noise generator), impedance (by an inductor), and capaci tance (by a capacitor). Adjustments may be made frequency dependent by a ?lter array (similar to 274b). A separate adjustor 608 is associated With each ?lter 275 alloWing individual adjustment of an attribute of the corresponding frequency band independent of other frequency bands. Each
device 601a and 601b is connected to medium 610 via a capacitor 605b and 605C respectively. Capacitors 605b and 605C prevent DC current from passing along medium 610 from device 601a to 601b and vice versa. A DC potential is passed from poWer supply 611 to devices 601a and 601b through the inductors 604a and 604b. Inductors 604a and 604b stop the transmission carrier from passing through poWer supply 611. Capacitor 605a shorts to ground 606 any residual carrier frequency that may pass through inductors 604a and 604b. A combination of such test ?xtures can be applied to more than tWo devices by applying an attenuator, capacitor and inductor to each of the connected devices.
[0107] FIG. 9 is a How chart illustration of a method to test signaling and data communication amongst a plurality of devices on a DC poWer line under varied media condi tions. Aplurality of devices such as devices 601a and 601b is connected 701 to a communication media 610. In the embodiment of FIG. 9, device 601a is a radio combined With a signal transmitter 350 and device 601b is a servo used for raising an antenna combined With a signal receiver 230. Communication betWeen devices 601a and 601b is con veyed by media 610. ApoWer supply 611 is used to supply
703 a DC voltage to devices 601a and 601b.
[0108] Attributes of medium 610 are adjusted 705 to represent a variety of communication conditions found in the ?eld. For eXample, in the embodiment of FIG. 9, devices
601a and 601b are components of a vehicle. In an automo
bile, devices 601a and 601b communicate by conveying signals over DC poWer supply lines of the automobile. The intention of the test of FIG. 9 is to test devices 601a and 601b under different conditions of voltage, noise and carrier attenuation. For eXample When devices 601a and 601b are installed into a small car the short length Wiring in the DC poWer system Will produce little attenuation of the commu nication carrier. On the other hand, electrical noise is highly
variable. When devices 601a and 601b are installed in a large truck, attenuation of the communication carrier Will be large because the carrier is conveyed over a long Wire in the electrical poWer system of the truck.
[0109] In the embodiment of FIG. 9 system 600 is used to simulate the conditions of a small car. DC poWer supply 611 supplies 12-volt DC poWer to devices 601a and 601b through coils 604a and 604b. Adjusters 608a and 608b are adjusted to reduce the amplitude of the communication carrier by 10 db simulating a DC poWer line of siX meters under certain load conditions. Adjusting media attributes 705 can also include adding noise by means of noise generator.
[0110] Once the medium is properly adjusted 705, a signal or arbitrary datum is sent 707 from device 601a to device

601b. Speci?cally, turning on the radio of device 601a prompts transmitter 350 to send 707 a “raise antenna” signal to receiver 230 of device 601b. Receiver 230 relays the signal to the servo of device 601b. The response of device 601b is observed to determine 708 if the signal Was received by device 601b. Speci?cally, if the servo of device 601b begins to function When the radio of device 601a is turned on, then communication is deemed acceptable. The highest alloWable attenuation level for reliable signaling may be measured in this embodiment by increasing attenuation of adjusters 608a and 608b until device 601b fails to receive a signal from device 601a.
[0111] Alternatively, sending a message 705 may include transmitting an arbitrary message. For eXample, in an alter native embodiment, device 601a may include a cellular telephone and device 601b may include a computer modem.

In the alternative embodiment, the message from device 601a to 601b Will be arbitrary data from the Internet and determination of reception Will be by viewing the received
data on a monitor. The arbitrary data bit error rate can be measured as a function of attenuation.
[0112] It is emphasized that the method and system for testing communication of the present invention is also
intended for more than tWo devices 601a and 601b. With an increased number of devices, a correspondingly increased number of adjusters permits adjusting 705 the attributes of medium 610 separately for communication betWeen speci?c devices in a netWork of multiple devices. For example, for three devices 601a, 601b, and 601c (not shoWn) With three adjusters 608a, 608b, and 608C (not shoWn) the attenuation
could be 10 db betWeen devices 601a and 601b and the attenuation could be only 6 db betWeen devices 601a and 601c and the attenuation could be 16 db betWeen devices 601b and 601c.
[0113] It is also emphasiZed that other attributes of media 610 could be adjusted. A noise generator may add noise to line 607 to simulate channel noise. Attributes that could be adjusted include but are not limited to as capacitance, inductance, and signal to noise ratio. Furthermore different components of the carrier can be adjusted separately. For eXample, using a set of parallel ?lters the attenuation could be adjusted separately for various frequency ranges.
[0114] While the invention has been described With respect to a limited number of embodiments, it Will be appreciated that many variations, modi?cations and other applications of the invention may be made.
[0115] It Will be appreciated that the above descriptions
are intended only to serve as examples, and that many other embodiments are possible Within the spirit and the scope of the present invention.
[0116] All publications, patents and patent applications
mentioned in this speci?cation are herein incorporated in their entirety by reference into the speci?cation, to the same eXtent as if each individual publication, patent or patent application Was speci?cally and individually indicated to be incorporated herein by reference. In addition, citation or identi?cation of any reference in this application shall not be construed as an admission that such reference is available as prior art to the present invention.

What is claimed is:
1. A method of transmitting an arbitrary datum over a channel and for sending a signal over the channel compris ing the steps:
(a) modulating a carrier of the channel by a modulation scheme for transmitting the arbitrary datum; and
(b) modifying said carrier by a modi?cation scheme for sending the signal.
2. The method of claim 1, Wherein said modulation scheme includes transmitting a plurality of consecutive symbols at a symbol rate and said modi?cation scheme includes modifying said carrier at a modi?cation rate, said modi?cation rate being higher than said symbol rate.
3. The method of claim 1, Wherein said modulation scheme includes transmitting a plurality of consecutive symbols at a symbol rate and said modi?cation scheme includes modifying said carrier at a modi?cation rate, said modi?cation rate being loWer than said symbol rate.
4. The method of claim 1, Wherein said step of modulating is effected according to a modulation scheme selected from the group consisting of BPSK, QPSK, AM, FM, CDMA.
5. The method of claim 1, Wherein said step of modifying is effected according to a modi?cation scheme selected from the group consisting of shifting a phase, shifting an ampli tude, and shifting a frequency.
6. The method of claim 1, Wherein the signal is used to communicate at least one message selected from the group consisting of an intention to transmit, an end of transmis sion, a congestion condition, an instruction to turn on a device, and instruction to turn off a device a request to retransmit and dominant and recessive statuses.
7. The method of claim 1, Wherein said carrier is con veyed by at least one medium selected from group consist ing of a utility poWer line, a DC poWer line, a dedicated communication Wire, a ?ber optic cable, a radio Wave, an ultra sonic Wave and magnetic ?eld.
8. The method of claim 1, Wherein said modulating and said modifying are effected substantially simultaneously.
9. The method of claim 1, further comprising the step:
c) altering said modi?cation scheme to adjust the prob ability of signaling errors.
10. A receiver for receiving an arbitrary datum from a channel of a communication carrier and for receiving a signal over the channel comprising:
(a) a modem for demodulating the arbitrary datum, the datum having been modulated by a modulation scheme; and
(b) a detector to detect the signal, the signal having been sent via modi?cations of the carrier according to a modi?cation scheme.
11. The receiver of claim 10, Wherein said modi?cation scheme includes a pattern of modi?cations to the carrier, and Wherein the receiver further comprises:
(c) a processor for identifying said pattern.
12. The receiver of claim 11, Wherein said modulation scheme includes modulating a symbol onto the carrier over a symbol period and said pattern includes a plurality of said modi?cations Within said symbol period.
13. The receiver of claim 11, Wherein said processor includes at least one circuit selected from the group con sisting of a programmable logic array device, an application speci?c integrated circuit, and a digital signal processor.
14. The receiver of claim 11, Wherein said modulation scheme includes modulating a plurality of symbols onto the carrier at a symbol rate and said pattern includes a plurality of said modi?cations at a modi?cation rate, said modi?ca tion rate being higher than said symbol rate.
15. The receiver of claim 11, Wherein said processor further evaluates communication performance.
16. The receiver of claim 10, Wherein a pattern identi? cation criterion is adjusted according to communication
performance.
17. The receiver of claim 10, Wherein said processor further adjusts a usage of a channel for an arbitrary datum transmission according to communication performance.
18. A transmitter for transmitting an arbitrary datum over a channel of a communication carrier and for sending a signal over the channel comprising:
