soldesign/SwarmPLCmodem/3NodeTest/3n_schematics.JPG

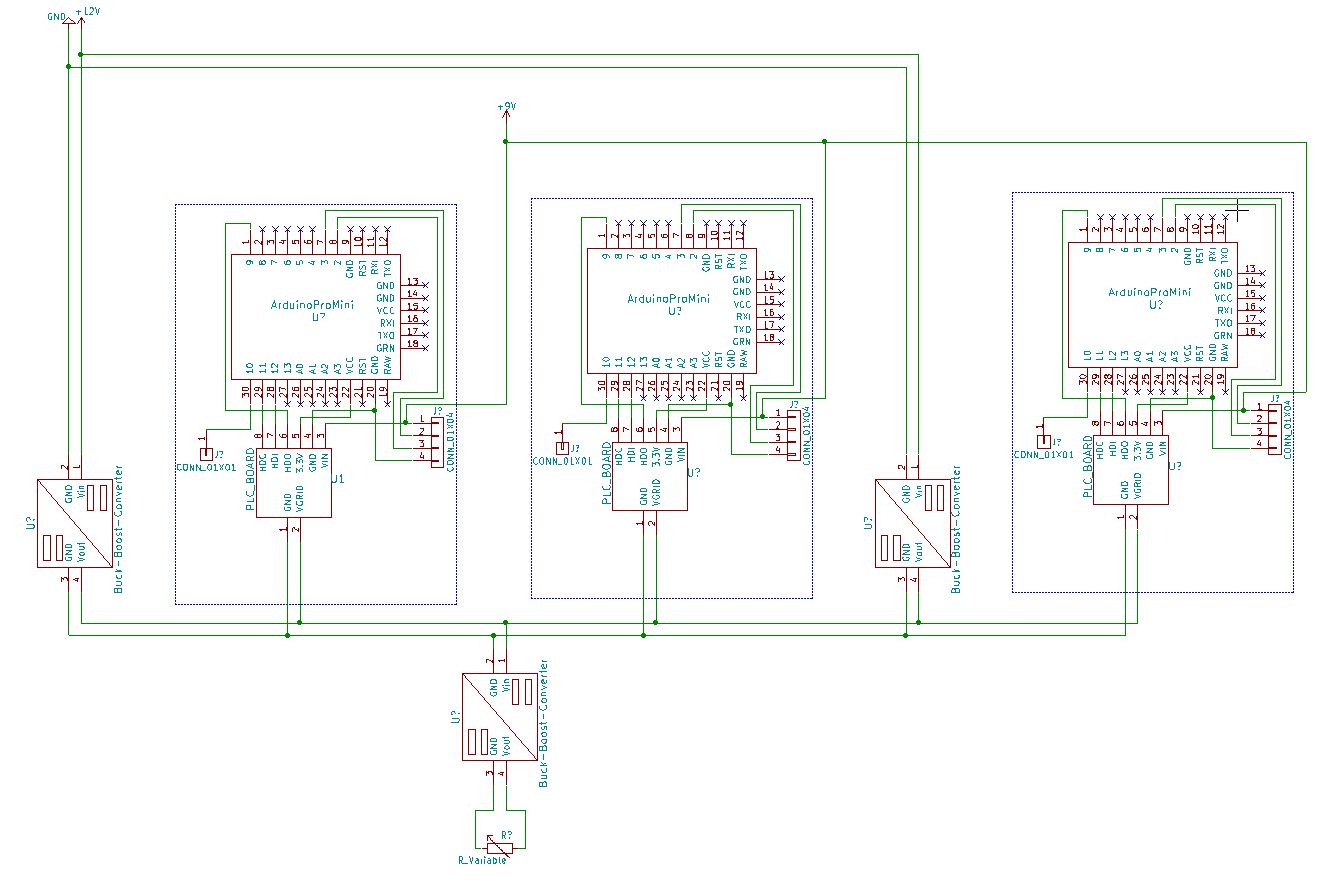
3NodeTest/3n_schematics.JPG
