soldesign/SwarmPLCmodem/20171201_165508.jpg

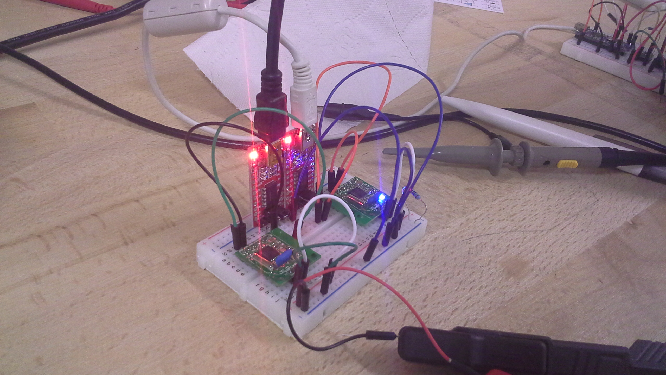
20171201_165508.jpg
