soldesign/SwarmPLCmodem/20180112_184055.jpg

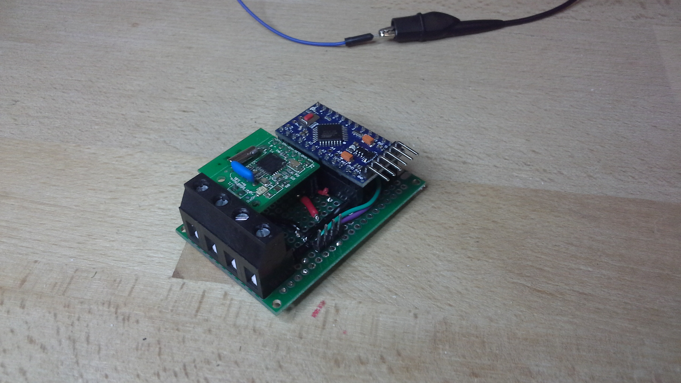
20180112_184055.jpg
