soldesign/SwarmPLCmodem/20180112_184104.jpg

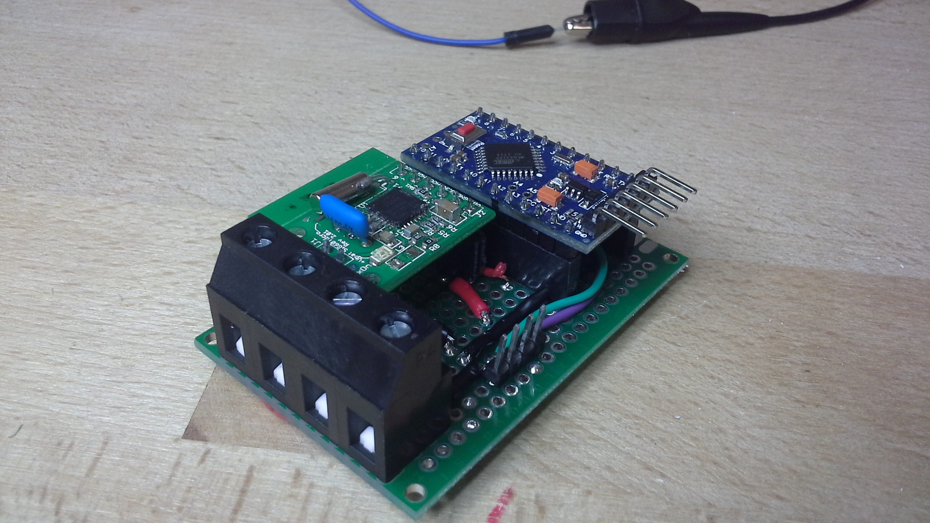
20180112_184104.jpg
