soldesign/SwarmPLCmodem/20180130_132724.jpg

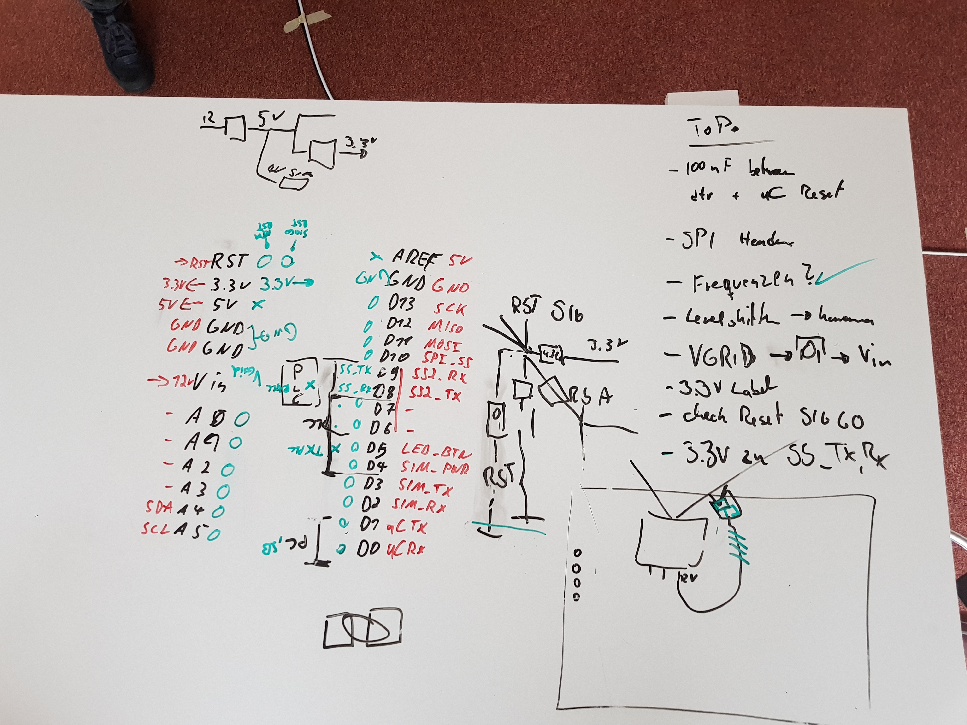
20180130_132724.jpg
