soldesign/SwarmPLCmodem/converter.png

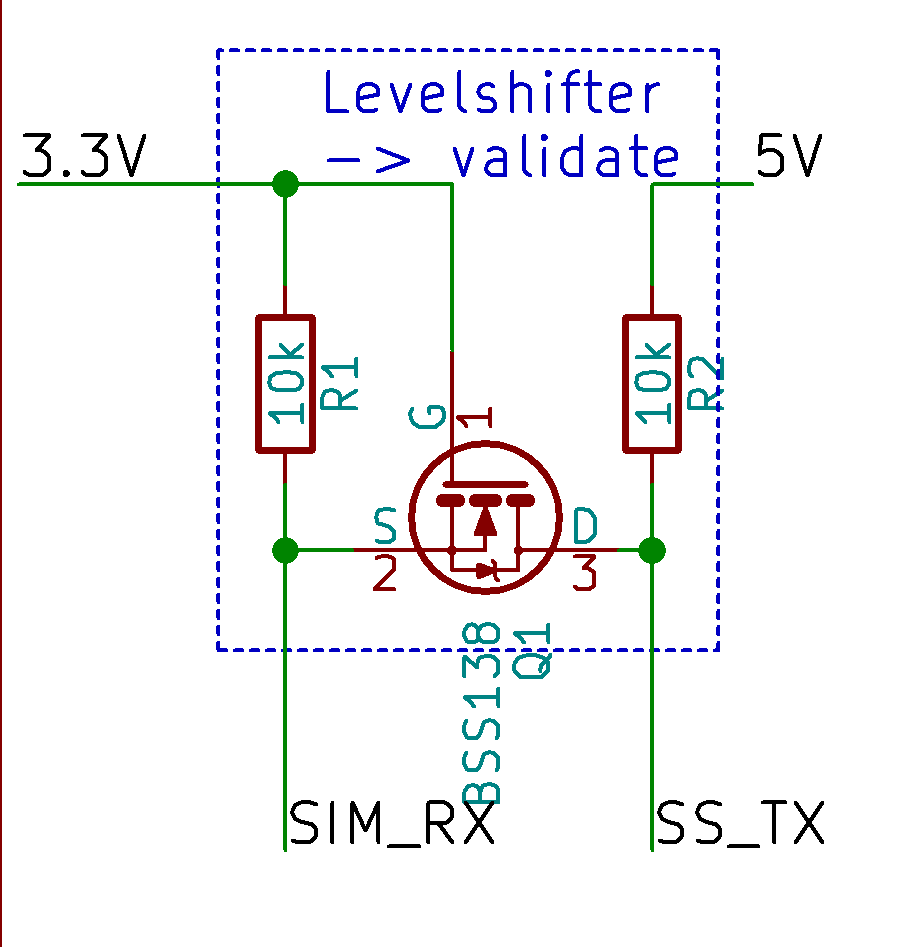
converter.png
