soldesign/SwarmPLCmodem/DecodePatent/0x00detsta.bmp

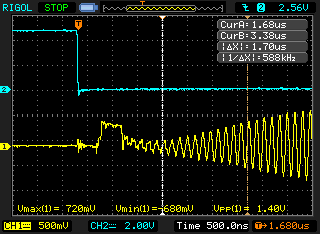
DecodePatent/0x00detsta.bmp
