soldesign/SwarmPLCmodem/DecodePatent/0x00genend.bmp

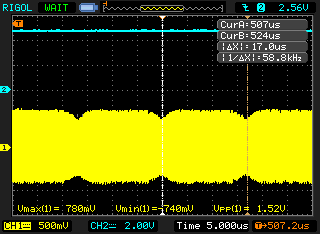
DecodePatent/0x00genend.bmp
