soldesign/SwarmPLCmodem/DecodePatent/0x00gensta.bmp

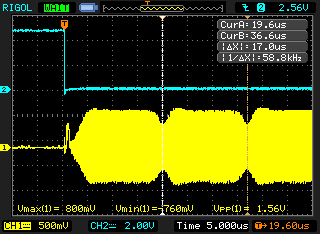
DecodePatent/0x00gensta.bmp
