soldesign/SwarmPLCmodem/DecodePatent/0xaadetneg.bmp

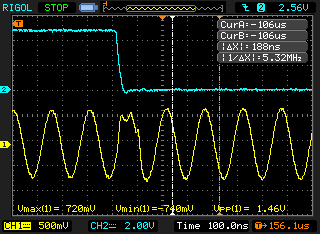
DecodePatent/0xaadetneg.bmp
