soldesign/SwarmPLCmodem/DecodePatent/0xaadetpos.bmp

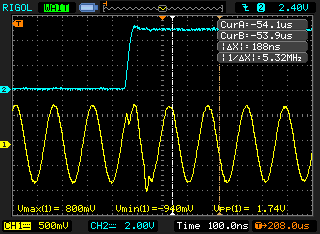
DecodePatent/0xaadetpos.bmp
