soldesign/SwarmPLCmodem/DecodePatent/0xffgenend.bmp

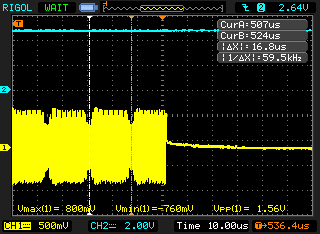
DecodePatent/0xffgenend.bmp
