soldesign/SwarmPLCmodem/DecodePatent/0xffgensta.bmp

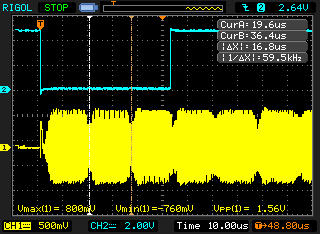
DecodePatent/0xffgensta.bmp
