soldesign/SwarmPLCmodem/FFT/FFT_python.png

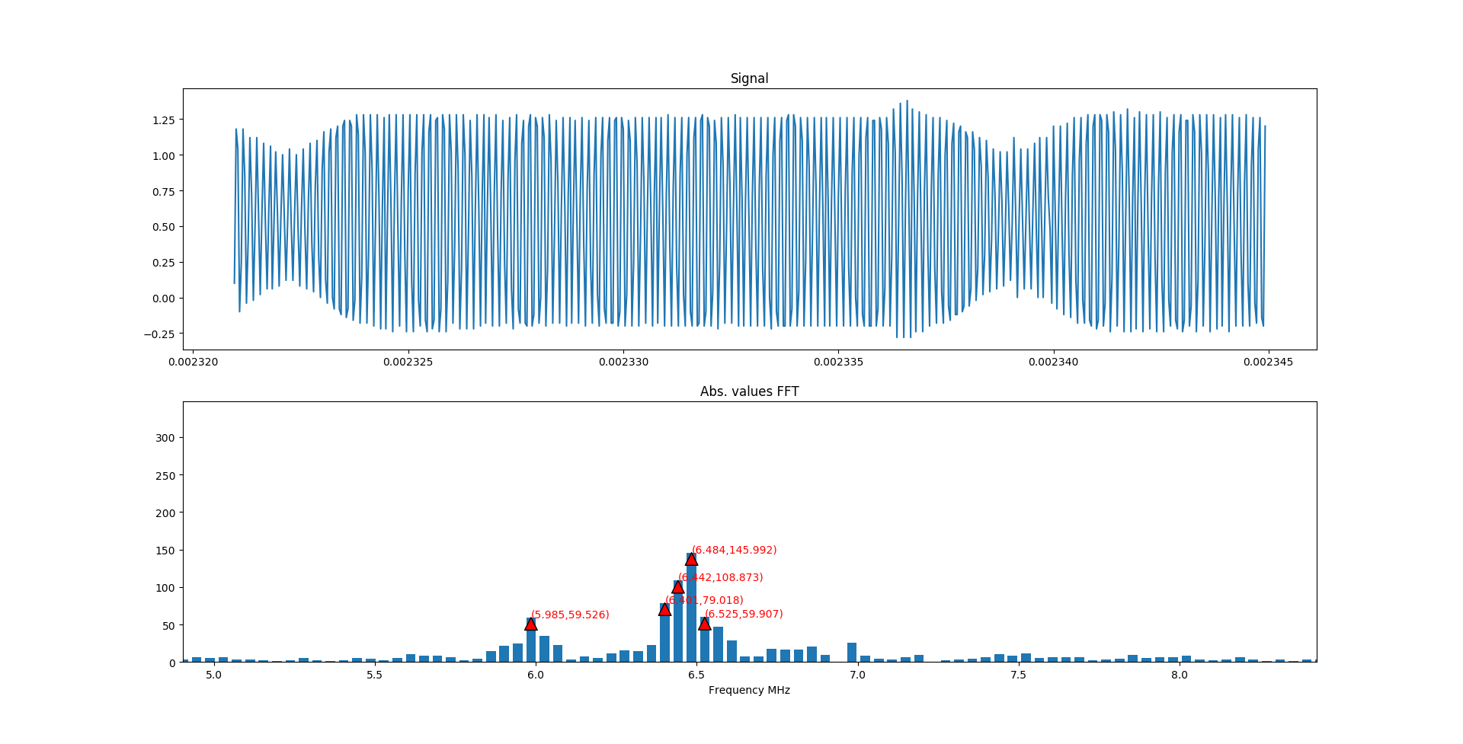
FFT/FFT_python.png
