soldesign/SwarmPLCmodem/FFT/FFT_simulated_BPSK.png

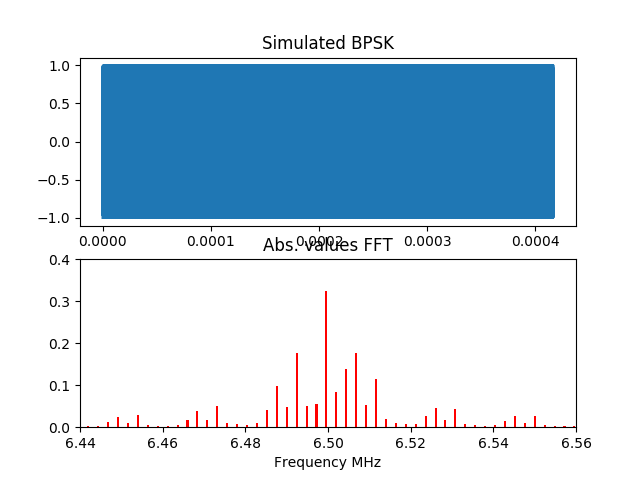
FFT/FFT_simulated_BPSK.png
