soldesign/SwarmPLCmodem/received_sig60.png

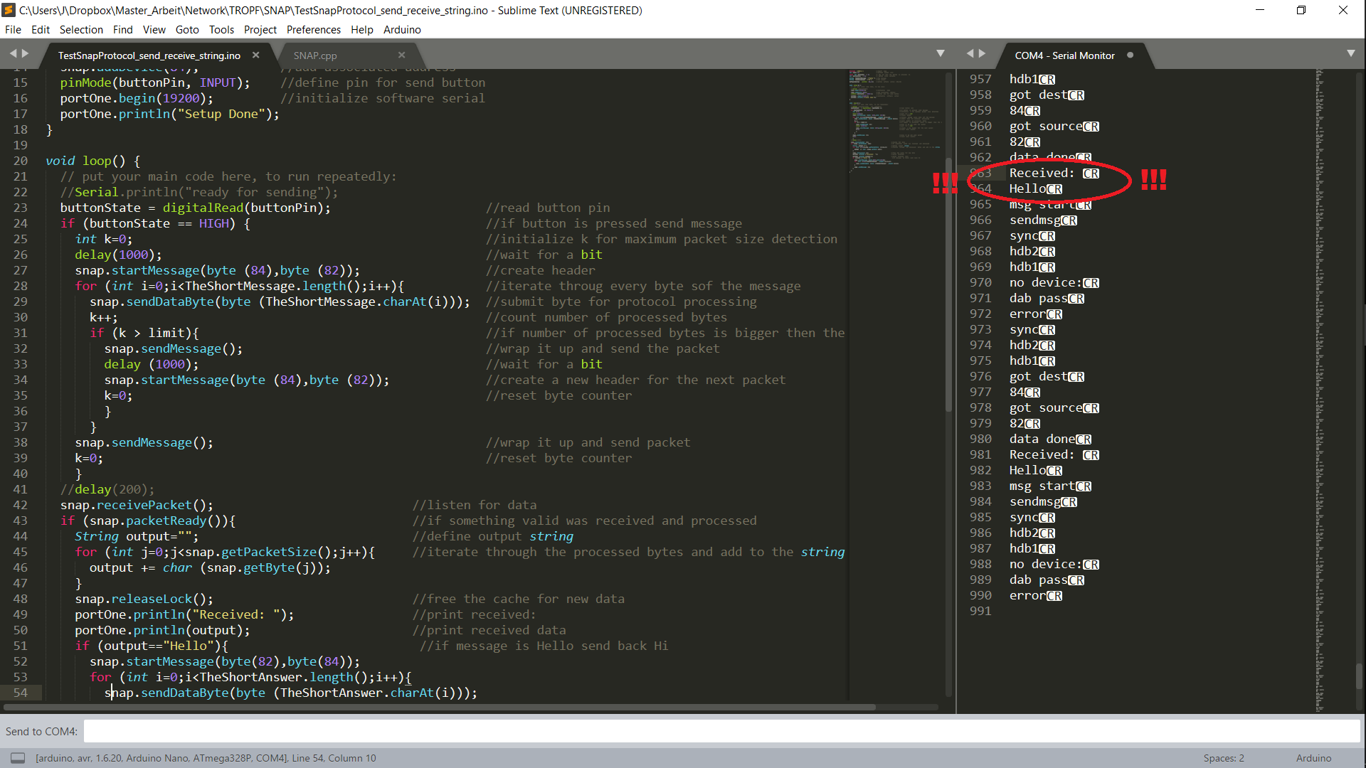
received_sig60.png
