soldesign/SwarmPLCmodem/rrrrrrrr.bmp

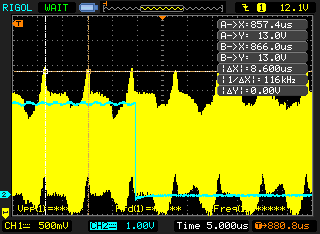
rrrrrrrr.bmp
