soldesign/SwarmPLCmodem/schematic_1.png

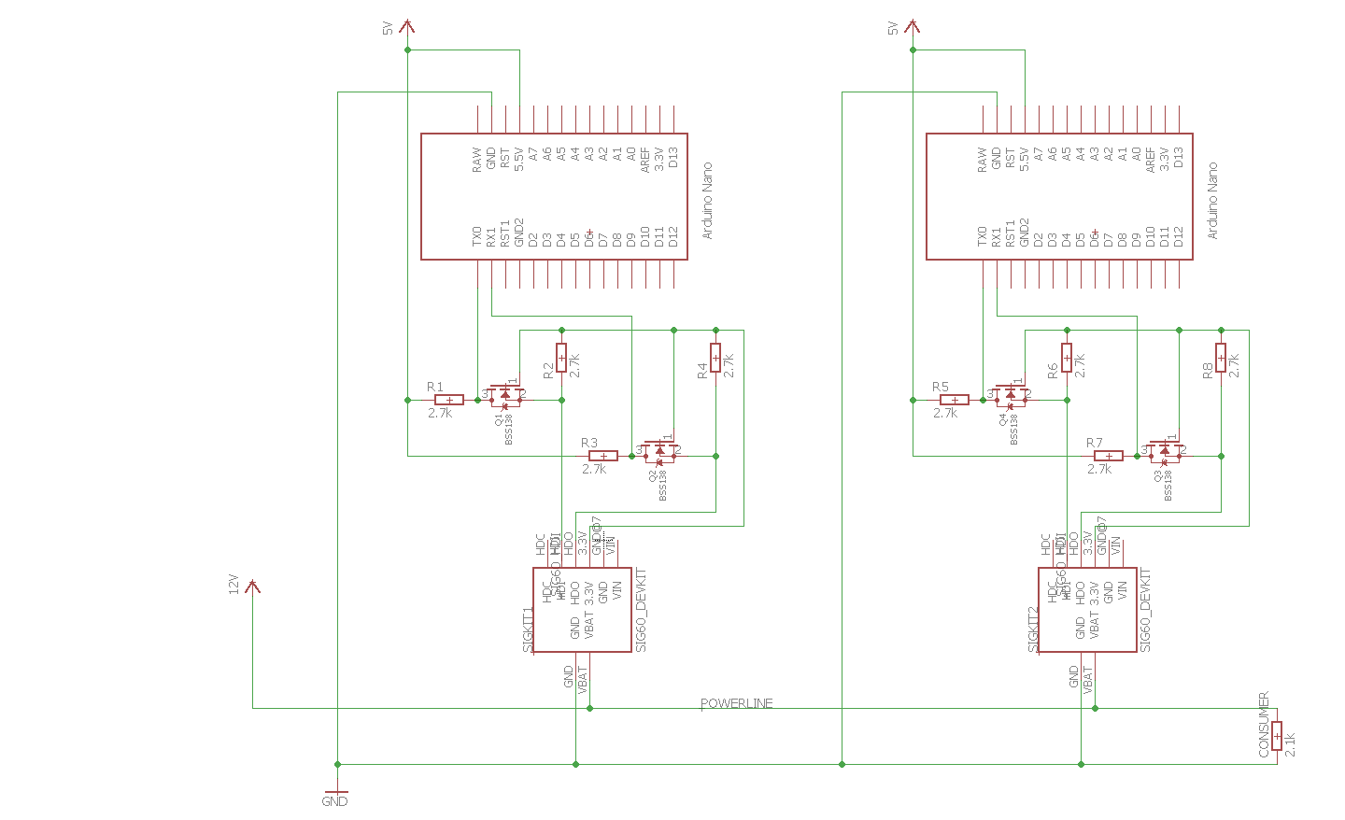
schematic_1.png
