soldesign/SwarmPLCmodem/serialPLCcom.png

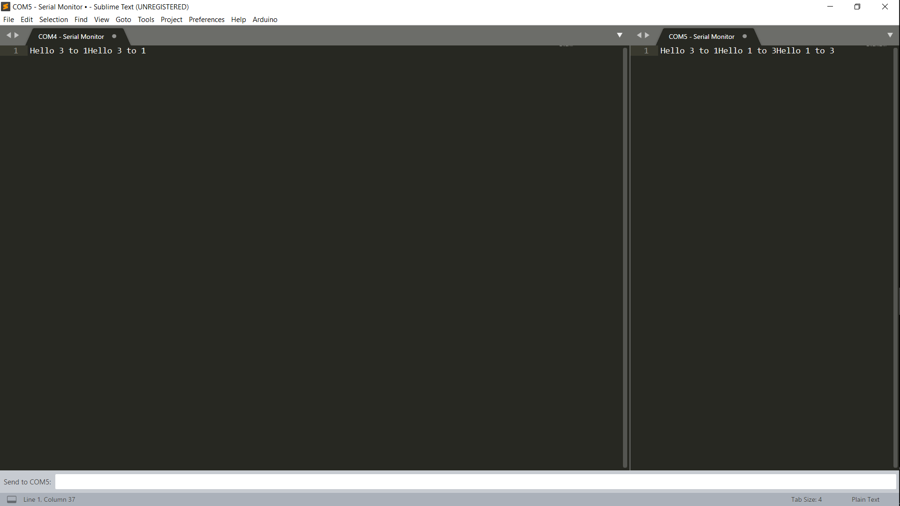
serialPLCcom.png
