soldesign/SwarmPLCmodem/SIG60_signal_UART_hires.bmp

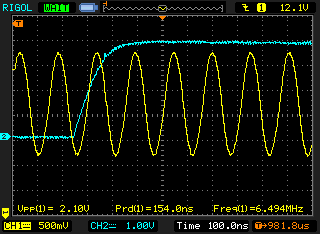
SIG60_signal_UART_hires.bmp
