soldesign/SwarmPLCmodem/SIG60_signal_UART_hires_2.bmp

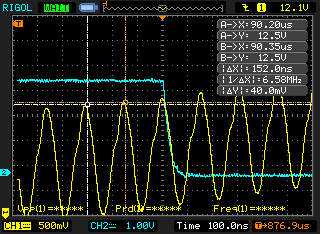
SIG60_signal_UART_hires_2.bmp
