soldesign/SwarmPLCmodem/SIG60_signal_UART_lores.bmp

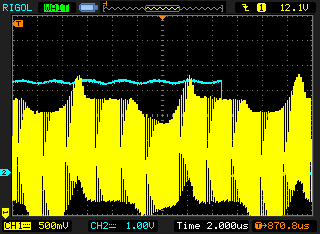
SIG60_signal_UART_lores.bmp
