soldesign/SwarmPLCmodem/SIG60_signal_UART_midres.bmp

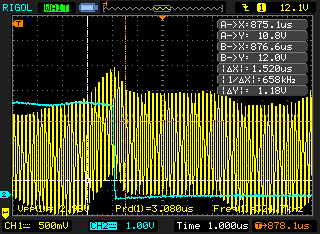
SIG60_signal_UART_midres.bmp
