soldesign/SwarmPLCmodem/SIG60_SOLSHARE/SIG60_SOLSHARE.png

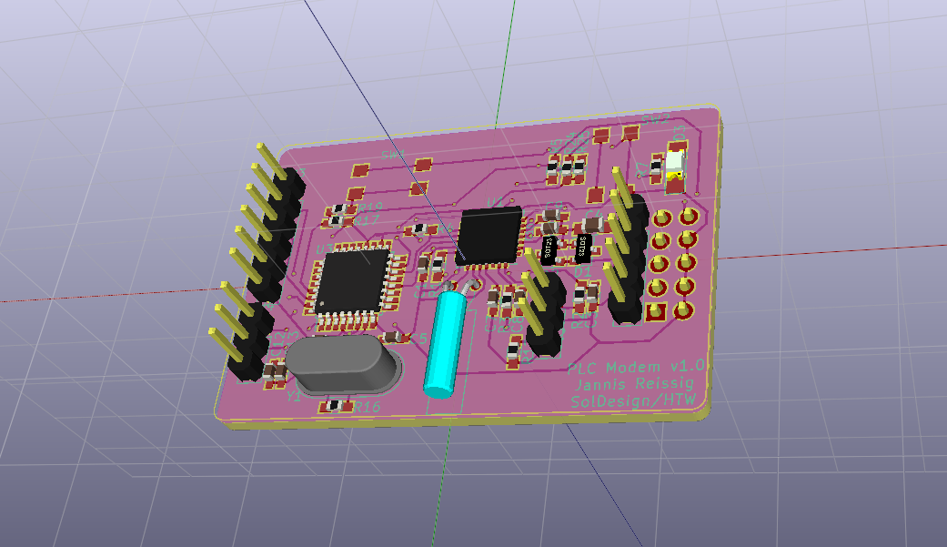
SIG60_SOLSHARE/SIG60_SOLSHARE.png
