soldesign/SwarmPLCmodem/SIG60_SOLSHARE/solbox_conn.png

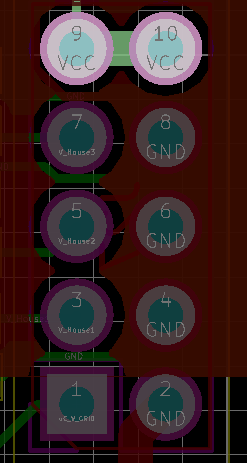
SIG60_SOLSHARE/solbox_conn.png
