soldesign/SwarmPLCmodem/Signal_UART_PLC1.bmp

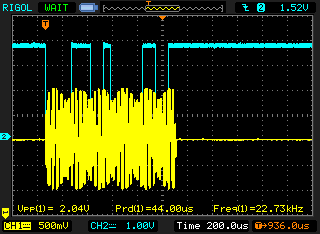
Signal_UART_PLC1.bmp
