soldesign/SwarmPLCmodem/Signal_UART_PLC2.bmp

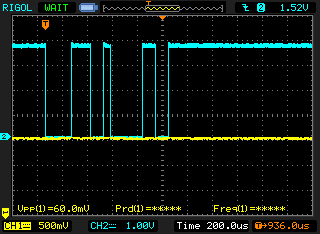
Signal_UART_PLC2.bmp
