soldesign/SwarmPLCmodem/Signal_UART_PLC3.bmp

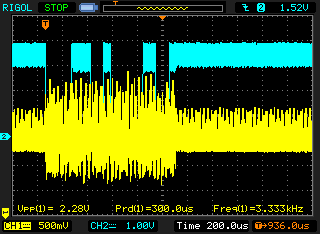
Signal_UART_PLC3.bmp
