soldesign/SwarmPLCmodem/xxxxxxxx.bmp

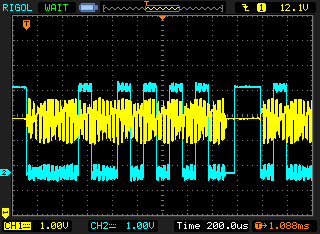
xxxxxxxx.bmp
