soldesign/SwarmPLCmodem/yyyyyyyy.bmp

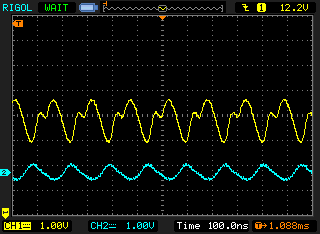
yyyyyyyy.bmp
