soldesign/SwarmPLCmodem/zzzzzzzz.bmp

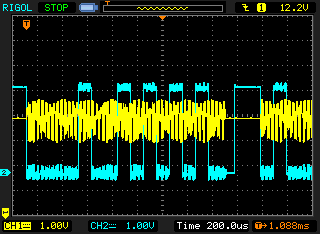
zzzzzzzz.bmp
