soldesign/SwarmPLCmodem/BOM-SIG60-micro-R2_01.pdf

Part List SIG60 Micro board Rev 2.01

Qty | Value | Device | Package | Part | Assembly | Statuts
1 | | FE06-1 | FE06 | J2 | TH
1 | 0.1u | C_0603 | C0603 | C1 | SMD
1 | 1.2K | R0603 | R0603 | R1 | SMD
3 | 100K | R0603 | R0603 | R4, R5, R6 | SMD
1 | 10n | C_0603 | C0603 | C8 | SMD
1 | 10u | C_1206 | C1206 | C2 | SMD
2 | 1K | R0603 | R0603 | R7, R12 | SMD
3 | 1n | C_0603 | C0603 | C3, C7, C10 | SMD
1 | 1u | C_0603 | C0603 | C6 | SMD
1 | 2.2n/100V | C_0805 | C0805 | C4 | SMD
1 | 220p | C_0603 | C0603 | C9 | SMD
1 | 39 | R1206 | R1206 | R9 | SMD
1 | 470 | R0603 | R0603 | R2 | SMD
1 | 4MHz | TC26H | TC26H | X1 | TH
1 | 6,8 | R0603 | R0603 | R3 | SMD
2 | BAS70-04 | BAS70-04 | SOT23 | D1, D2 | SMD
1 | FILTER | FILTER | 3 holes | Filter | TH
1 | HZ1206C202R-10 | L_1206 | L1206 | L3 | SMD
0 | NC | R0603 | R0603 | R8 | NC
1 | Powerline | MTA02-100 | 10X02MTA | J1 | TH
1 | REG1117 | REG1117 | SOT223 | U2 | SMD
1 | RxOn | LED_0805 | LED_0805 | D3 | SMD
1 | SIG60 | SIG60 | QFN28-ML_6X6MM U1 | | SMD
2 | 0 | R0603 | SW0603 | SW1, SW2 | SMD
1 | | PCB
