soldesign/SwarmPLCmodem/3NodeTest/Protocol_3n_test.docx

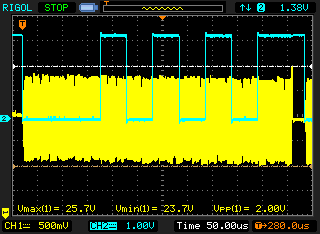
[picture p34: figure]
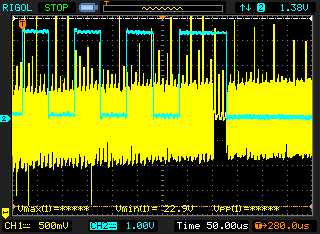
[picture p35: figure]
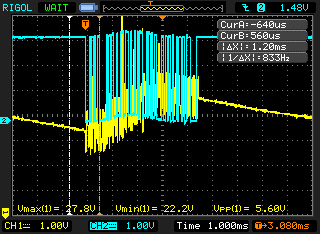
[picture p36: figure]
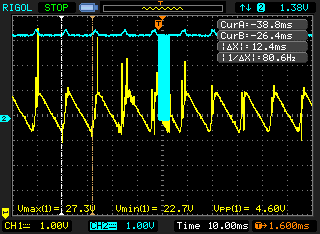
[picture p37: figure]
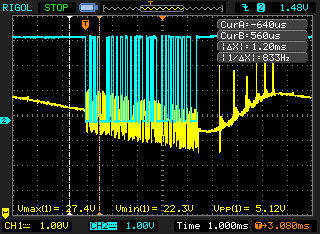
[picture p38: figure]
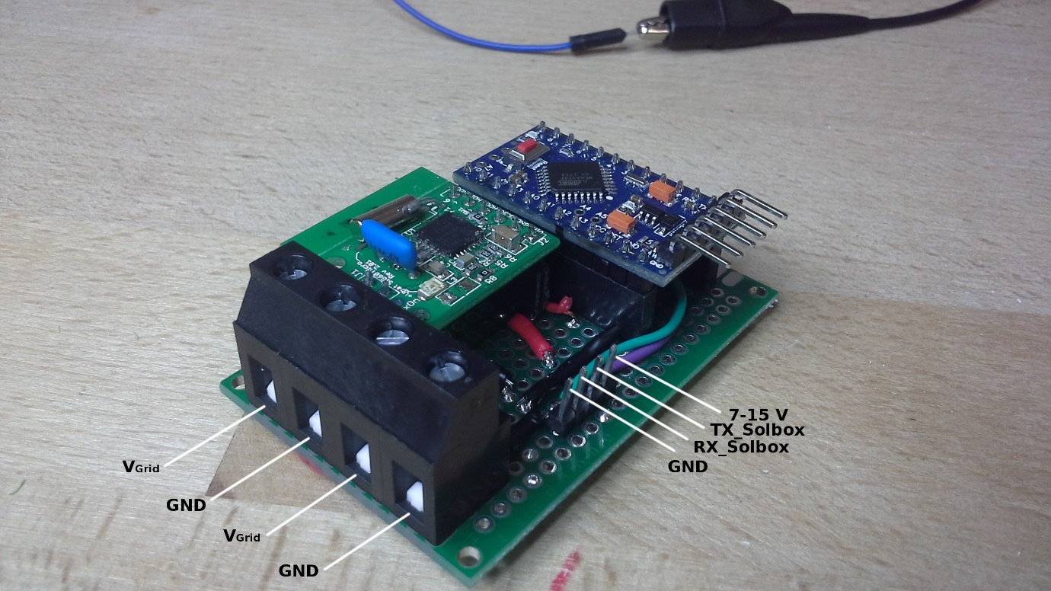
[picture p39: figure]
