soldesign/SwarmPLCmodem/3NodeTest/3nrs4fftno.csv

X | CH1
Second | Volt
1.7760000e-04 | -1.20000e-01
1.7780000e-04 | -1.20000e-01
1.7800000e-04 | -1.20000e-01
1.7819999e-04 | -1.20000e-01
1.7839999e-04 | -1.20000e-01
1.7859999e-04 | -1.20000e-01
1.7879999e-04 | -1.20000e-01
1.7900000e-04 | 2.00000e-02
1.7920000e-04 | 6.00000e-02
1.7940000e-04 | 1.40000e-01
1.7960000e-04 | 1.40000e-01
1.7980000e-04 | 1.34000e+00
1.7999999e-04 | 1.80000e-01
1.8019999e-04 | -8.00000e-02
1.8039999e-04 | -8.00000e-02
1.8059999e-04 | 4.00000e-02
1.8079999e-04 | 2.00000e-02
1.8100000e-04 | 1.40000e-01
1.8120000e-04 | 1.60000e-01
1.8140000e-04 | 7.40000e-01
1.8160000e-04 | 2.20000e-01
1.8180000e-04 | -1.00000e-01
1.8199999e-04 | -1.00000e-01
1.8219999e-04 | 6.00000e-02
1.8239999e-04 | 6.00000e-02
1.8259999e-04 | 1.60000e-01
1.8279999e-04 | 1.60000e-01
1.8300000e-04 | 2.20000e+00
1.8320000e-04 | 1.80000e-01
1.8340000e-04 | -1.00000e-01
1.8360000e-04 | -1.00000e-01
1.8380000e-04 | 6.00000e-02
1.8399999e-04 | 6.00000e-02
1.8419999e-04 | 1.80000e-01
1.8439999e-04 | 1.60000e-01
1.8459999e-04 | 1.72000e+00
1.8480000e-04 | 1.80000e-01
1.8500000e-04 | -1.00000e-01
1.8520000e-04 | -4.00000e-02
1.8540000e-04 | 8.00000e-02
1.8560000e-04 | 8.00000e-02
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
