soldesign/SwarmPLCmodem/BuckBoost/Results.xlsx

IBuck | USupply | ISupply | PSupply | UGrid | UCon | ICon | PCon | PLoss | Datapass
0.1 | 12.000 | 0.280 | 3.360 | 14.450 | 12.100 | 0.100 | 1.210 | 2.150 | Yes
0.2 | 12.000 | 0.380 | 4.560 | 14.450 | 12.100 | 0.190 | 2.299 | 2.261 | Yes
0.3 | 12.000 | 0.510 | 6.120 | 14.460 | 12.100 | 0.290 | 3.509 | 2.611 | Yes
0.4 | 12.000 | 0.630 | 7.560 | 14.480 | 12.100 | 0.400 | 4.840 | 2.720 | Yes
0.5 | 12.000 | 0.735 | 8.820 | 14.480 | 12.100 | 0.480 | 5.808 | 3.012 | Yes
0.6 | 12.000 | 0.860 | 10.320 | 14.470 | 12.100 | 0.590 | 7.139 | 3.181 | Yes
0.7 | 12.000 | 0.990 | 11.880 | 14.470 | 12.100 | 0.690 | 8.349 | 3.531 | Yes
0.8 | 12.000 | 1.090 | 13.080 | 14.460 | 12.100 | 0.780 | 9.438 | 3.642 | Yes
0.9 | 12.000 | 1.220 | 14.640 | 14.460 | 12.100 | 0.890 | 10.769 | 3.871 | Yes
1 | 10.500 | 1.350 | 14.175 | 14.450 | 12.000 | 0.990 | 11.880 | 2.295 | Yes
1.1 | 10.300 | 1.460 | 15.038 | 14.450 | 10.600 | 1.080 | 11.448 | 3.590 | Yes
1.2 | 10.300 | 1.580 | 16.274 | 10.630 | 9.400 | 1.190 | 11.186 | 5.088 | Yes
1.3 | 10.400 | 1.580 | 16.432 | 10.220 | 8.900 | 1.290 | 11.481 | 4.951 | Yes
1.4 | 10.500 | 1.580 | 16.590 | 10.020 | 8.600 | 1.385 | 11.911 | 4.679 | Yes
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
