soldesign/SwarmPLCmodem/3NodeTest/3nrr40m_.bmp

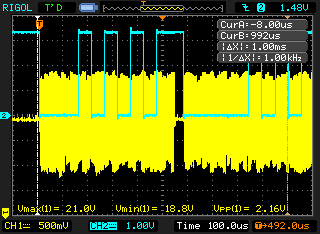
3NodeTest/3nrr40m_.bmp
