soldesign/SwarmPLCmodem/3NodeTest/3ntrigen_.bmp

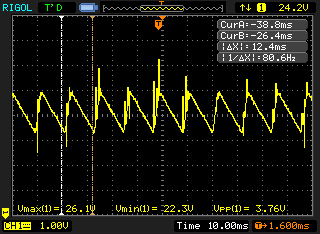
3NodeTest/3ntrigen_.bmp
