soldesign/SwarmPLCmodem/3NodeTest/3ntrimea.bmp

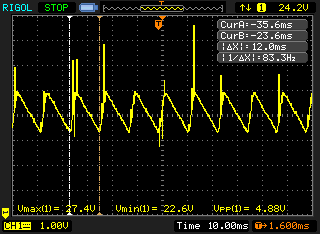
3NodeTest/3ntrimea.bmp
