soldesign/SwarmPLCmodem/handout.pdf

16.01.2018

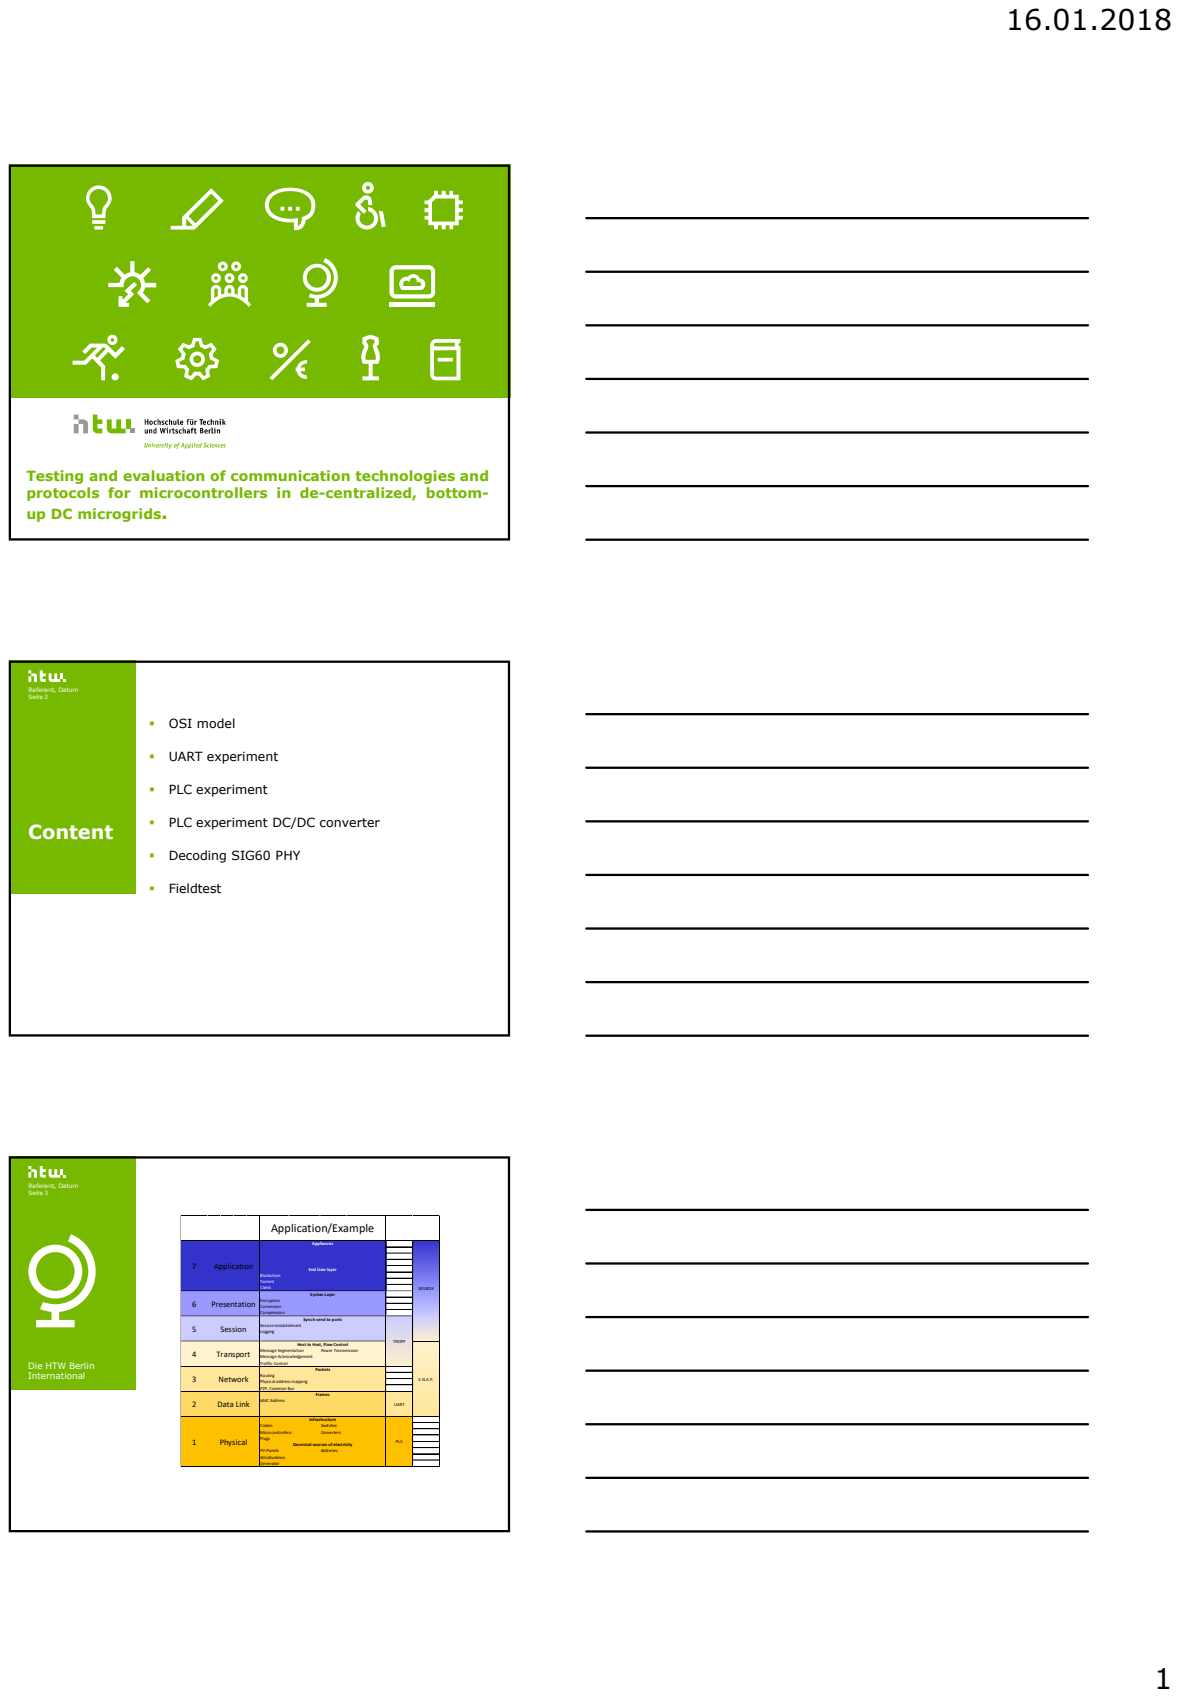
[picture p43: page 1]
Fieldtest Seite 3 Die HTW Berlin International Referent, Datum; © Gregor Strutz/Axel Völcker

Testing and evaluation of communication technologies and
protocols for microcontrollers in de-centralized, bottom-
up DC microgrids. Seite 2 Content Referent, Datum

OSI model UART experiment PLC experiment PLC experiment DC/DC converter Decoding SIG60 PHY

Transport | Appliances Application/Example Microcontrollers Windturbines Batteries Cables

7 Application | Syntax Layer Synch send to ports End User layer Session establishment Conversion Compression | SOLBOX Blockchain

4 | Torrent Client Frames Packets Plugs Switches Converters P2P, Common Bus MAC Address Logging PV-Panels Generator Network Data Link Presentation
5 Session | Encryption Message Segmentation Message Acknowledgement Traffic Control Power Transmission Routing 6
3 | Infrastructure Decentral sources of electricity Host to Host, Flow Control 1 | | S.N.A.P. TROPF PLC

Physical 2 | Physical address mapping | UART

16.01.2018

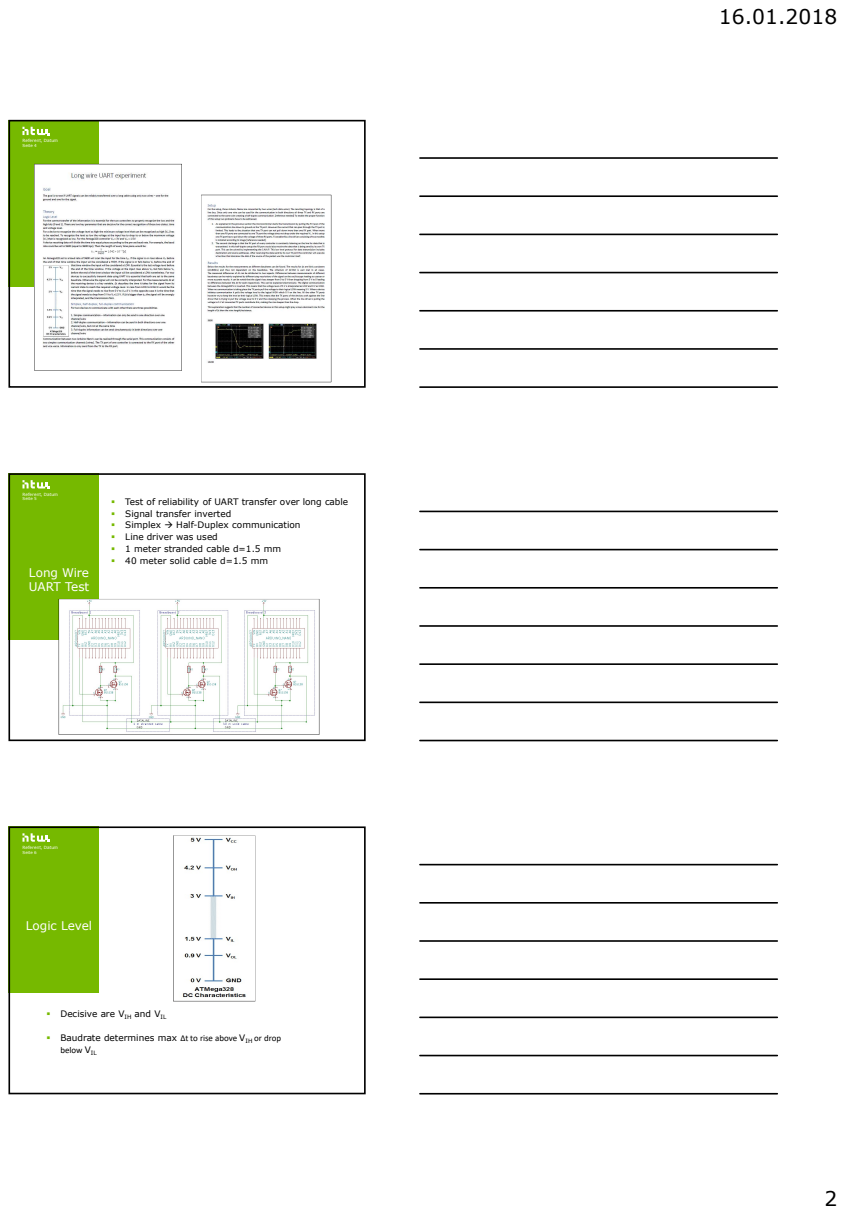
[picture p44: page 2]
Seite 4 Referent, Datum; © DOM publishers; Long Wire; UART Test; Test of reliability of UART transfer over long cable; Seite 6; Referent, Datum

40 meter solid cable d=1.5 mm Referent, Datum
Seite 5

Signal transfer inverted
Simplex Half-Duplex communication
Line driver was used
1 meter stranded cable d=1.5 mm

Logic Level Decisive are VIH and VIL

Baudrate determines max Δt to rise above VIH or drop
below VIL

16.01.2018

# Baud rate 9600 Baud rate 115200 Seite 8

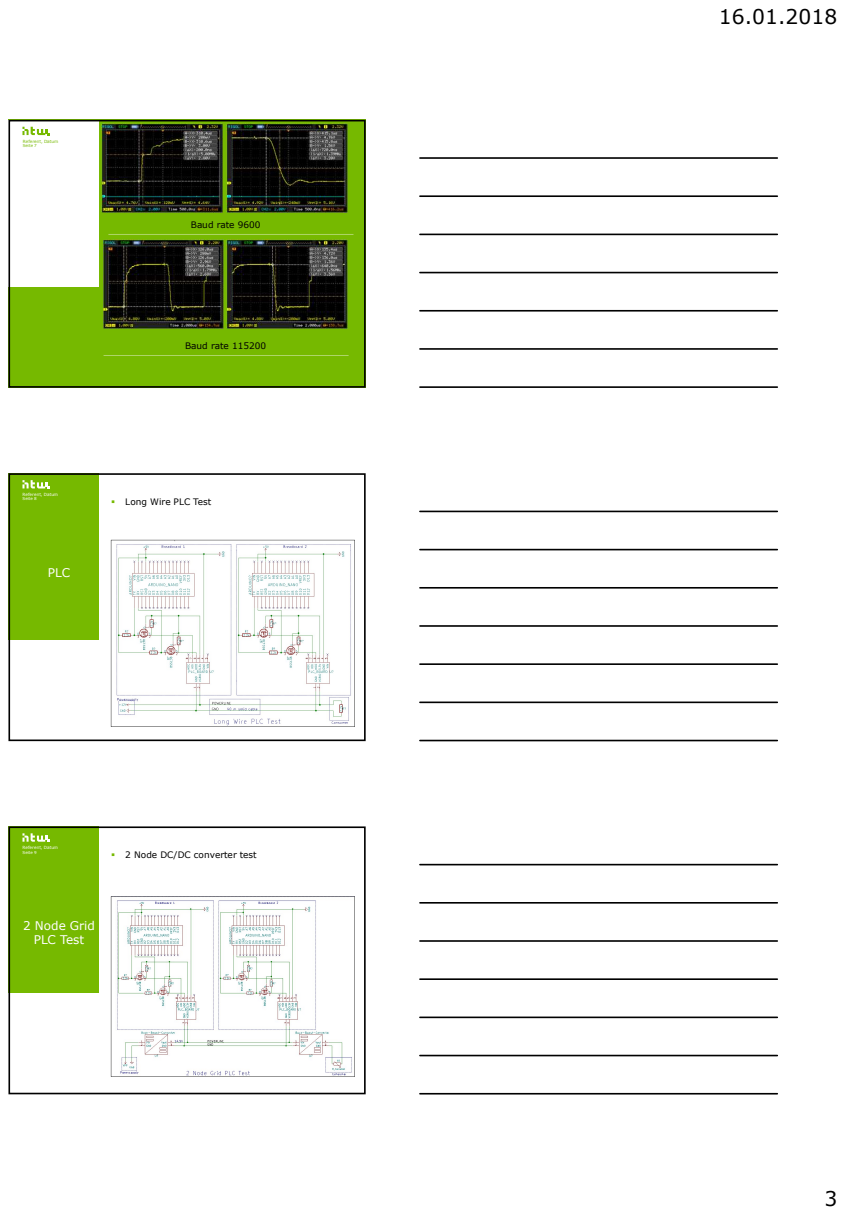
[picture p45: page 3]
PLC; Seite 9; 2 Node Grid; PLC Test; 2 Node DC/DC converter test Referent, Datum

Seite 7 Referent, Datum

Long Wire PLC Test Referent, Datum

16.01.2018

# 2 Node Grid

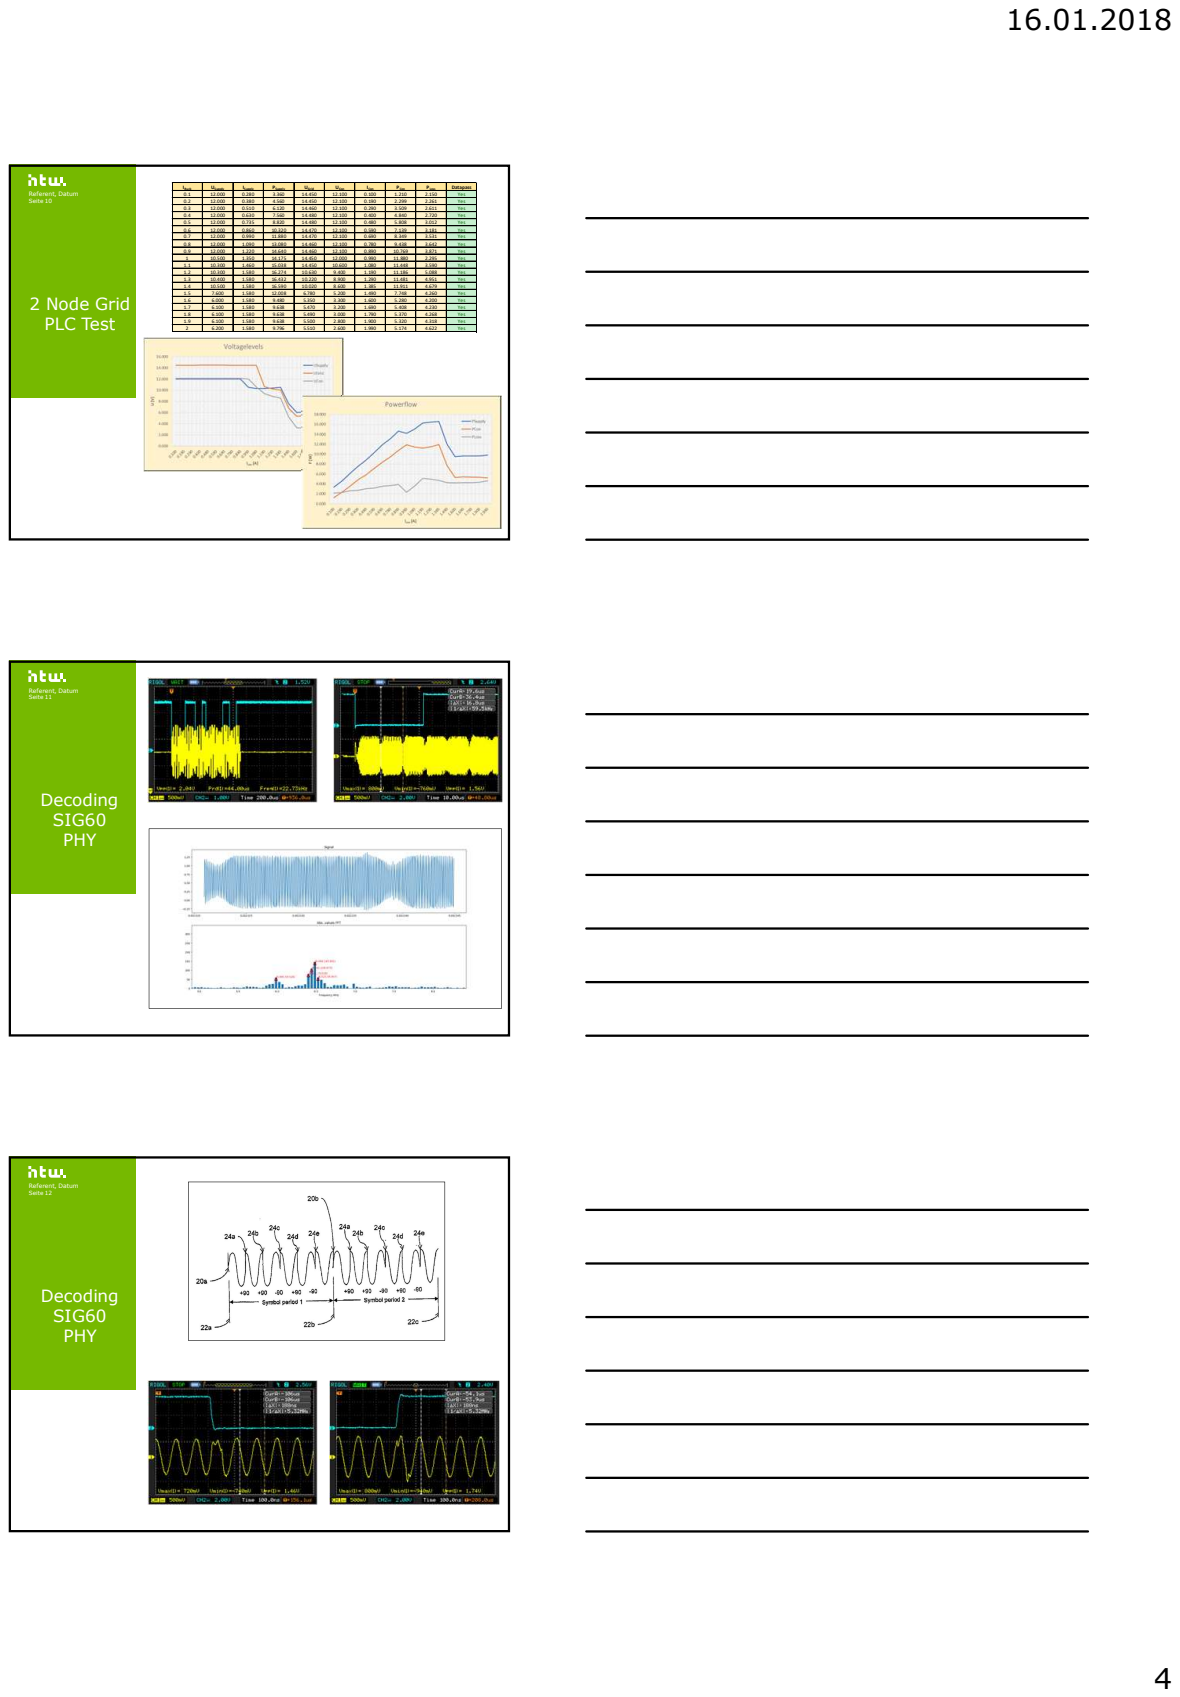
[picture p46: page 4]
IBuck; USupply; ISupply; PSupply; UGrid; UCon; ICon; PCon; PLoss; Datapass 0.1; Yes 0.2; Yes 0.3; Yes 0.4; Yes 0.5; Yes 0.6; Yes 0.7; Yes 0.8; Yes 0.9; Yes 1; Yes 1.1; Yes 1.2; Yes 1.3; Yes 1.4; Yes 1.5; Yes 1.6; Yes 1.7; Yes 1.8; Yes 1.9; Yes 2; Yes Seite 11 Decoding; SIG60

PLC Test Referent, Datum
Seite 10

PHY Referent, Datum

Seite 12 Decoding

16.01.2018

# Seite 13 Decoding

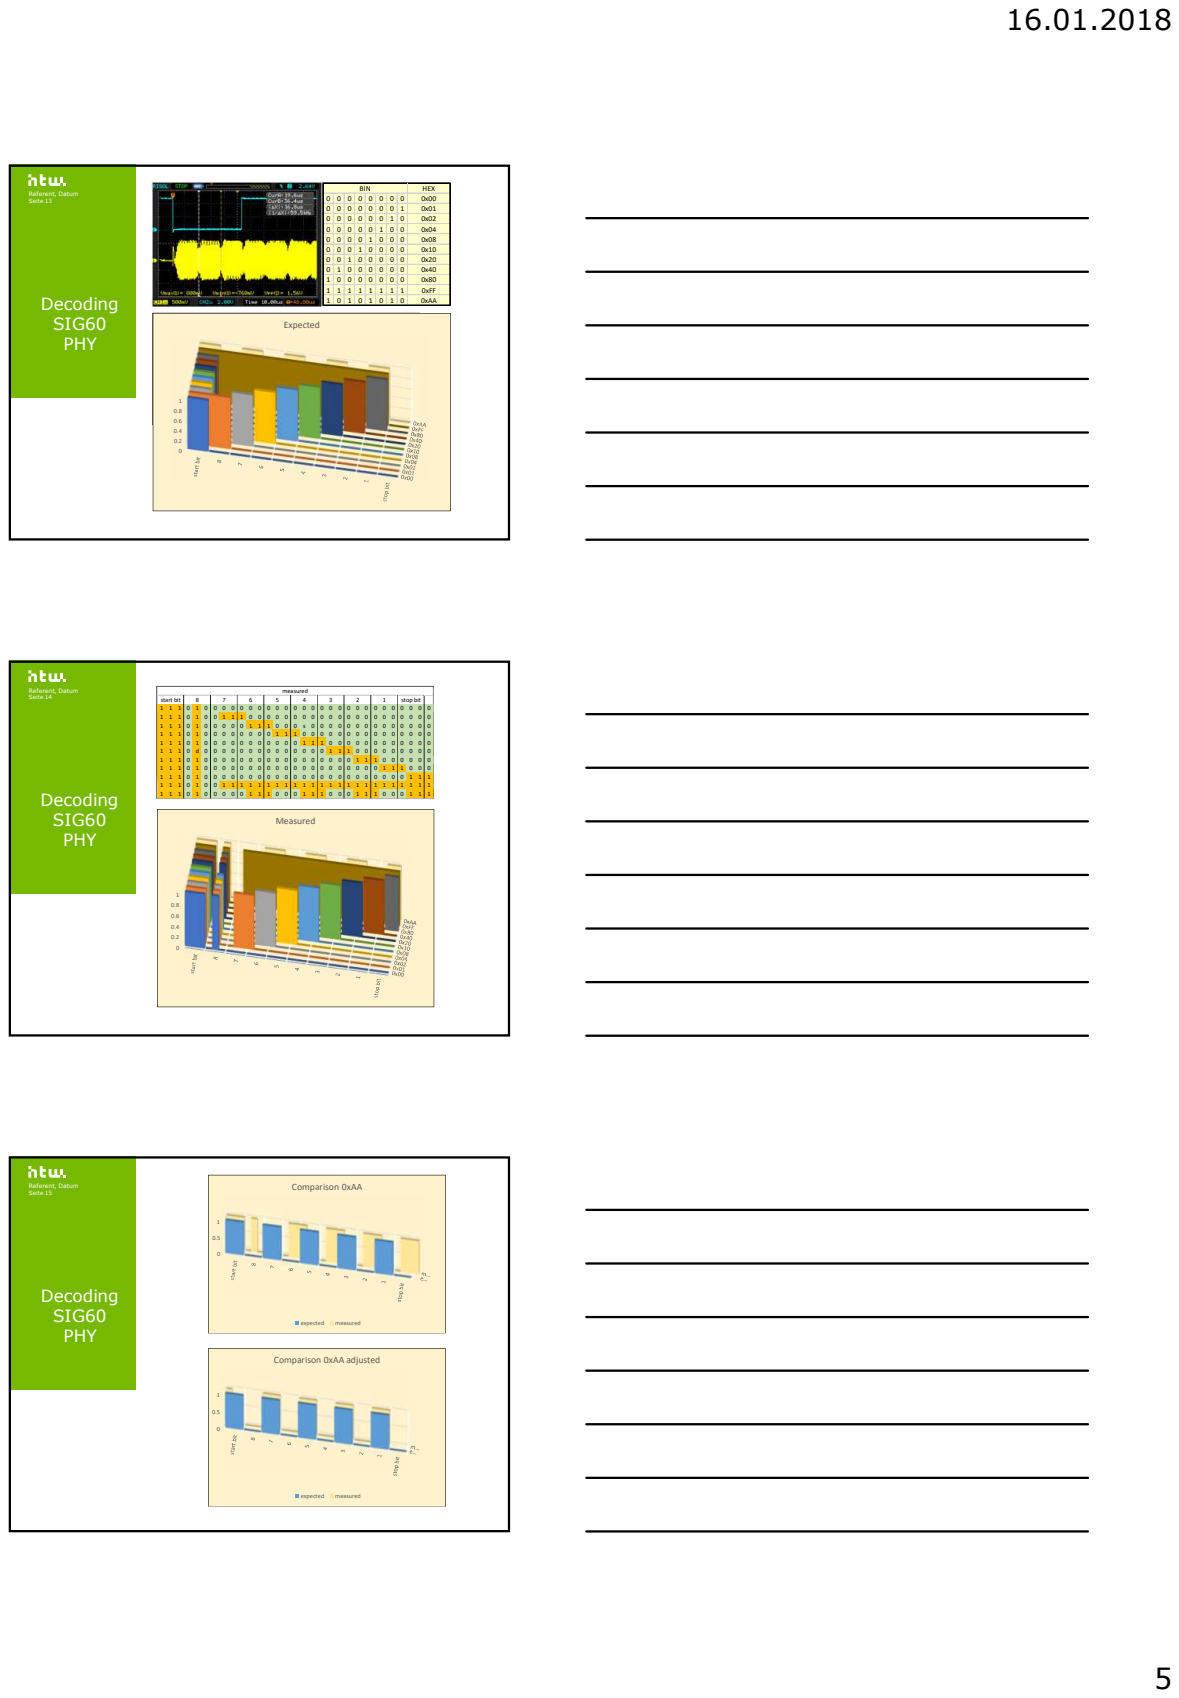
[picture p47: page 5]
expected; start bit; stop bit HEX; SIG60; 1 measured; stop bit 0; measured; 1 Comparison 0xAA adjusted

PHY Referent, Datum

0 0 | 0 0 0 0 0 0 0x00
0 0 | 0 0 0 0 0 1 0x01
0 0 | 0 0 0 0 1 0 0x02
0 0 | 0 0 0 1 0 0 0x04
0 0 | 0 0 1 0 0 0 0x08
0 0 | 0 1 0 0 0 0 0x10
0 0 | 1 0 0 0 0 0 0x20
0 1 | 0 0 0 0 0 0 0x40
1 0 | 0 0 0 0 0 0 0x80
1 1 0 | 1 1 1 0 1 1 1 0 1 1 1 0 0xAA 0xFF 1

BIN

SIG60
Expected Seite 14 Decoding

1 Measured Seite 15 Decoding

1 Comparison 0xAA

16.01.2018

# PLC

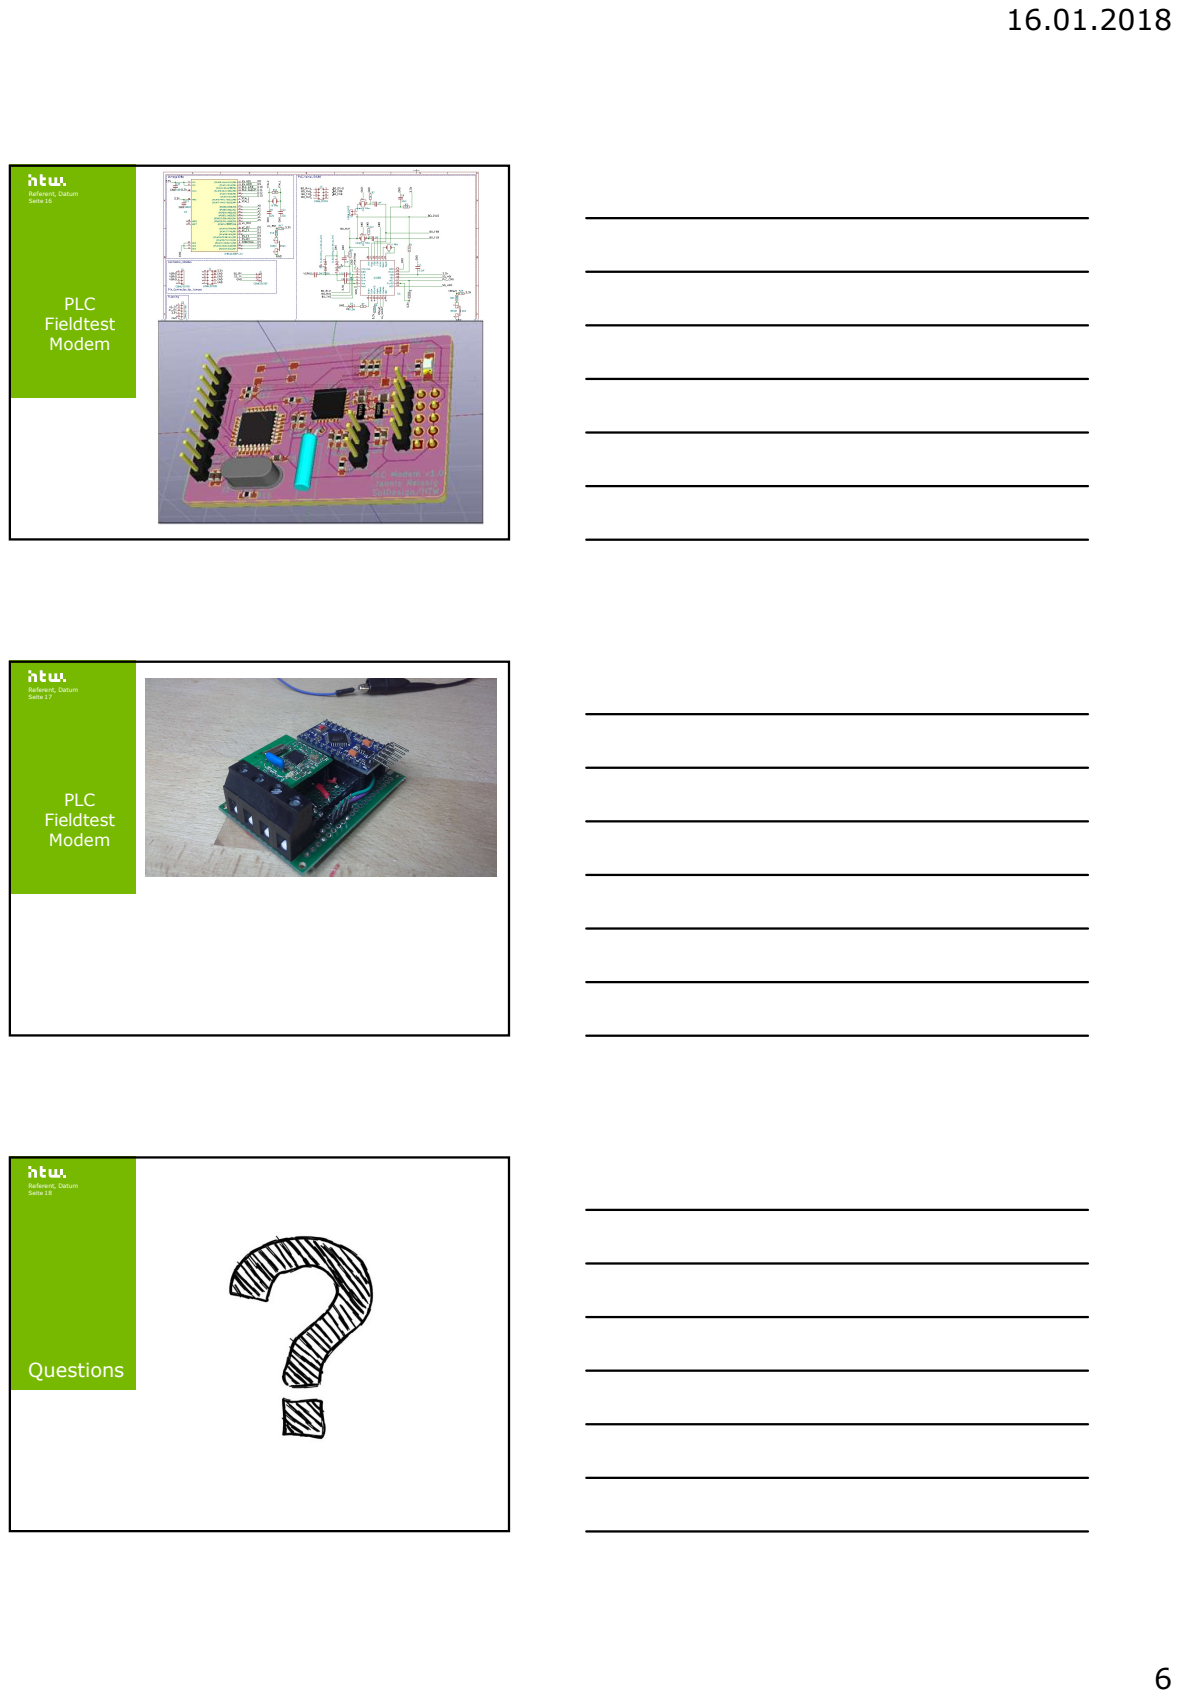
[picture p48: page 6]
Seite 16; Fieldtest Modem; Referent, Datum; Seite 17; PLC Fieldtest Modem

Seite 18 Questions Referent, Datum
