soldesign/SwarmPLCmodem/(commit log)

2018-01-03 last save before change
    [SIG60_SOLSHARE.sch, _saved_SIG60_SOLSHARE.sch]
2018-01-03 first 3.3V layout without traces
    [SIG60_SOLSHARE.kicad_pcb, SIG60_SOLSHARE.sch]
2018-01-08 finished 3.3V PLC modul with atmega & sig 60
    [Channel_vis.xlsx, Results.xlsx, SIG60_SOLSHARE.kicad_pcb, SIG60_SOLSHARE.sch]
2018-01-08 fine tuning PLC modem v1.0
    [SIG60_SOLSHARE-B.Cu.gbr, SIG60_SOLSHARE-B.Mask.gbr, SIG60_SOLSHARE-B.SilkS.gbr, SIG60_SOLSHARE-Edge.Cuts.gbr, SIG60_SOLSHARE-F.Cu.gbr, SIG60_SOLSHARE-F.Mask.gbr, SIG60_SOLSHARE-F.SilkS.gbr, SIG60_SOLSHARE.drl]
2018-01-08 edited schematic for extra frequency channel;corrected mistake in schematic;mistake still in pcb layout
    [SIG60_SOLSHARE.sch]
2018-01-15 cleanup before further PLC development
    [0x00detsta.csv, 0x08detneg.csv, 0xaadetneg.csv, Bitword analysis.xlsx, NewFile0.csv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]
2018-01-31 Working PLC test console with ping, add device, delete device and list device.
    [3nrs4fft.csv, 3nrs4fftno.csv, SIG60_Fieldtest.sch, SIG60_Lib.xlsx, SIG60_SOLSHARE.sch, _saved_SIG60_SOLSHARE.sch, consumption (version 1).xlsb.xlsx, consumption protocol.xlsx]
2018-01-31 last experiments added. extended doc on plc modem. arduino footprint included in plc schematics.
    [SIG60_SOLSHARE.sch, _saved_SIG60_SOLSHARE.sch]
2018-02-01 schematics changed. uno footprint added, lvl shifter added.
    [SIG60_SOLSHARE.sch, _saved_SIG60_SOLSHARE.sch]
2018-02-01 Finished Schematics. No PCB design.
    [SIG60_SOLSHARE.kicad_pcb, SIG60_SOLSHARE.sch, _saved_SIG60_SOLSHARE.sch]
2018-02-05 Version 1.1 of PLC modul schematics. Bugfixes + Improvements
    [SIG60_SOLSHARE.sch]
